hatlabs/HALSPA-hardware/HALSPA.kicad_sch

## KiCad design HALSPA.kicad_sch (2026-04-21)

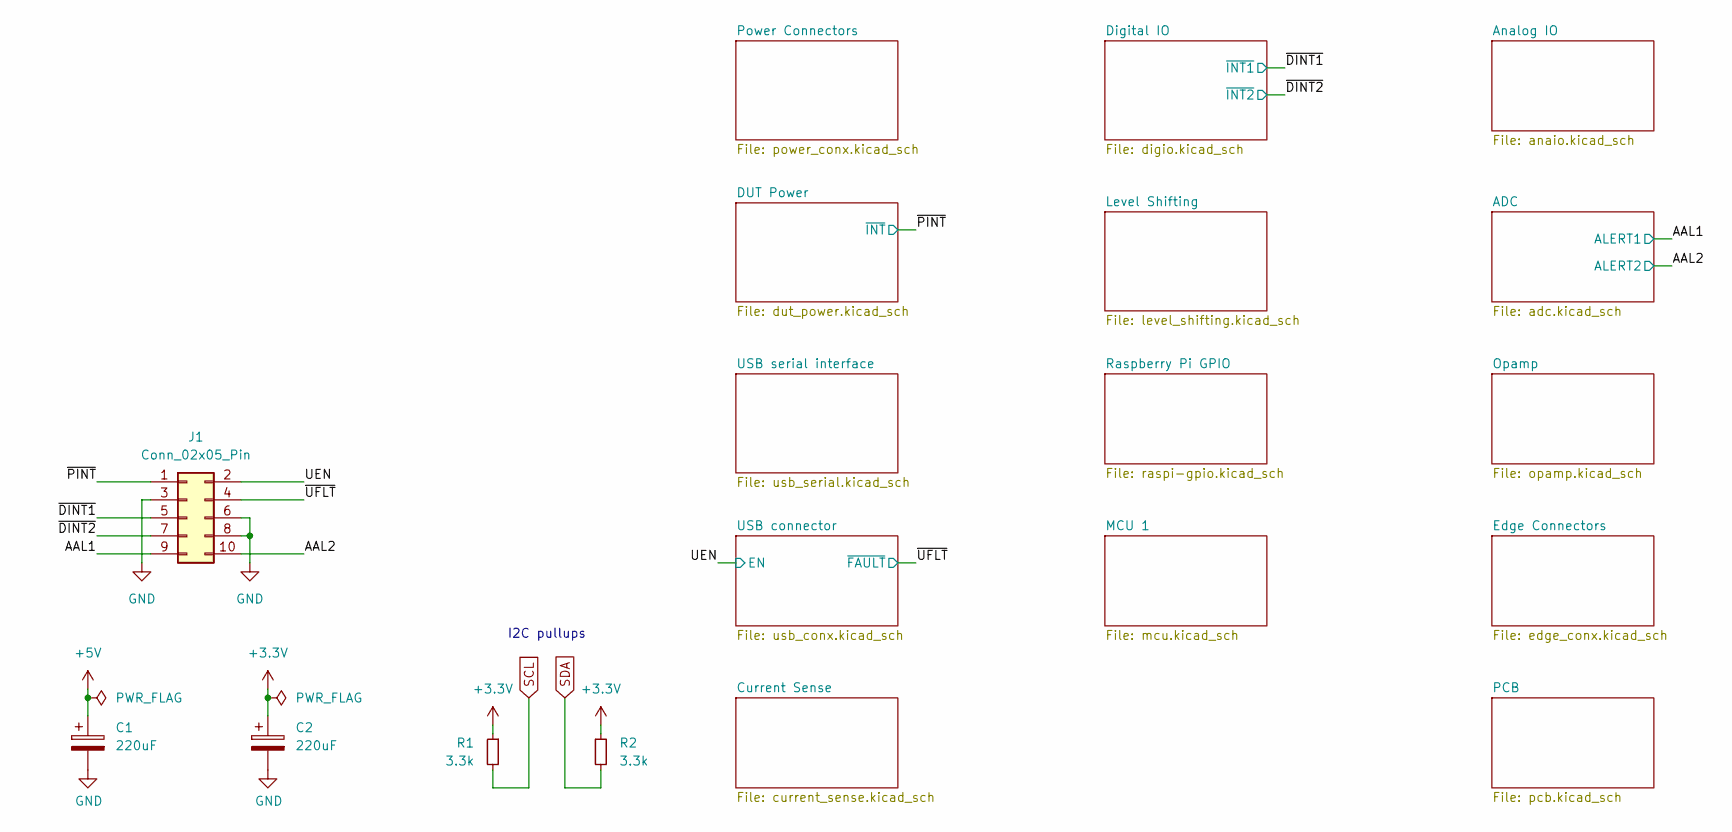
[picture p1: schematic HALSPA.kicad_sch]

Parts:
C1, C2: 220uF; CP_Elec_6.3x7.7; LCSC C5246526
J1: Conn_02x05_Pin; Pad_2x05_P2.54_1.7x1.7_2Rect-8Oct; JLCPCB_CORRECTION 1.27;-5.08;270
R1, R2: 3.3k; R_0603_1608Metric; LCSC C22978

Connections:
+3.3V: C2.1, R1.1, R2.1
+5V: C1.1
AAL1: J1.9
AAL2: J1.10
GND: C1.2, C2.2, J1.3, J1.6, J1.8
SCL: R1.2
SDA: R2.2
UEN: J1.2
~DINT1: J1.5
~DINT2: J1.7
~PINT: J1.1
~UFLT: J1.4

Notes on the sheet:
I2C pullups
