hatlabs/HALSPA-hardware/ads1115.kicad_sch

## KiCad design ads1115.kicad_sch (2026-04-21)

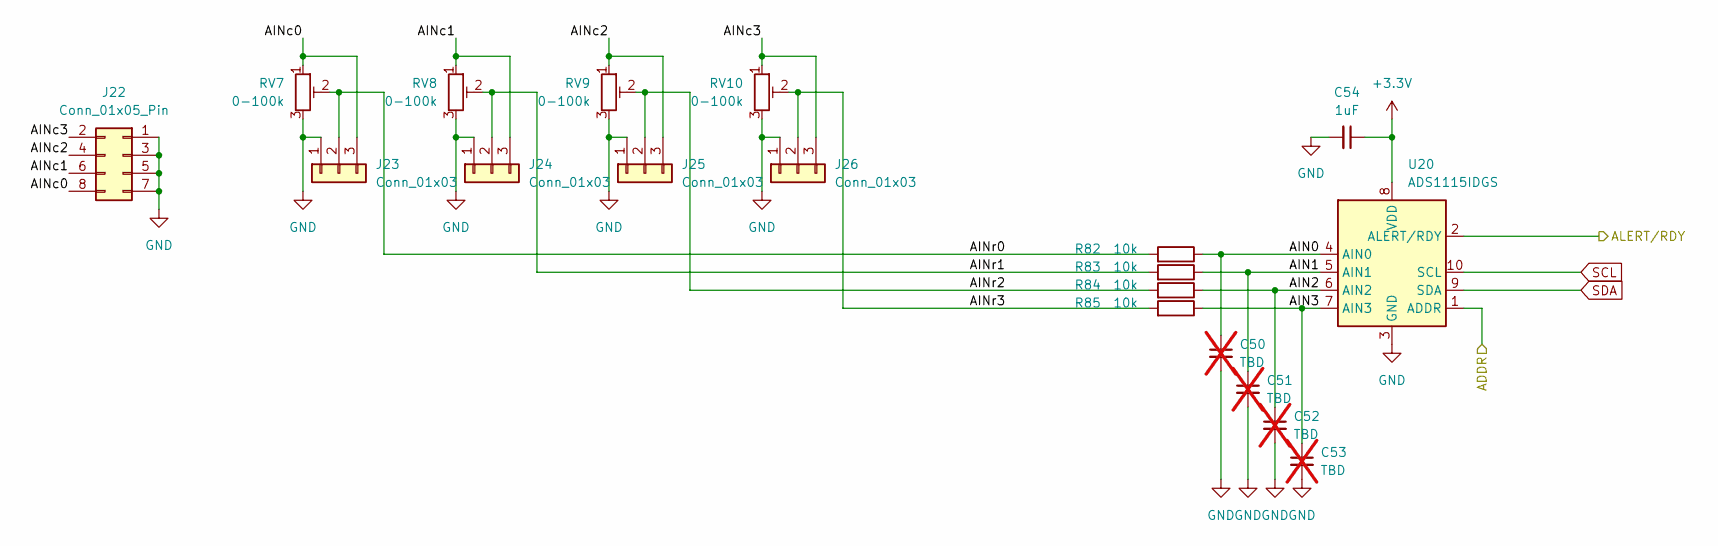
[picture p2: schematic ads1115.kicad_sch]

Parts:
C50, C51, C52, C53: TBD; C_0603_1608Metric; not fitted
C54: 1uF; C_0603_1608Metric_Pad1.08x0.95mm_HandSolder; LCSC C15849
J22: Conn_01x05_Pin; Pad_2x04_P2.54_1.7x1.7_Rect-Oct; LCSC C492421
J23, J24, J25, J26: Conn_01x03; Pad_1x03_P2.00_1.35x1.35_Rect-2Oct
R82, R83, R84, R85: 10k; R_0805_2012Metric_Pad1.20x1.40mm_HandSolder; LCSC C17414
RV7, RV8, RV9, RV10: 0-100k; RES-ADJ-TH_3P-L9.5-W4.9-P2.50-L_3296W; LCSC C118963
U20: ADS1115IDGS; TSSOP-10_3x3mm_P0.5mm; LCSC C37593

Connections:
+3.3V: C54.1, U20.8 (VDD)
ADDR: U20.1 (ADDR)
AIN0: C50.1, R82.1, U20.4 (AIN0)
AIN1: C51.1, R83.1, U20.5 (AIN1)
AIN2: C52.1, R84.1, U20.6 (AIN2)
AIN3: C53.1, R85.1, U20.7 (AIN3)
AINc0: J22.8, J23.3, RV7.1
AINc1: J22.6, J24.3, RV8.1
AINc2: J22.4, J25.3, RV9.1
AINc3: J22.2, J26.3, RV10.1
AINr0: J23.2, R82.2, RV7.2
AINr1: J24.2, R83.2, RV8.2
AINr2: J25.2, R84.2, RV9.2
AINr3: J26.2, R85.2, RV10.2
ALERT/RDY: U20.2 (ALERT/RDY)
GND: C50.2, C51.2, C52.2, C53.2, C54.2, J22.1, J22.3, J22.5, J22.7, J23.1, J24.1, J25.1, J26.1, RV7.3, RV8.3, RV9.3, RV10.3, U20.3 (GND)
SCL: U20.10 (SCL)
SDA: U20.9 (SDA)
