hatlabs/HALSPA-hardware/anaio.kicad_sch

## KiCad design anaio.kicad_sch (2026-04-21)

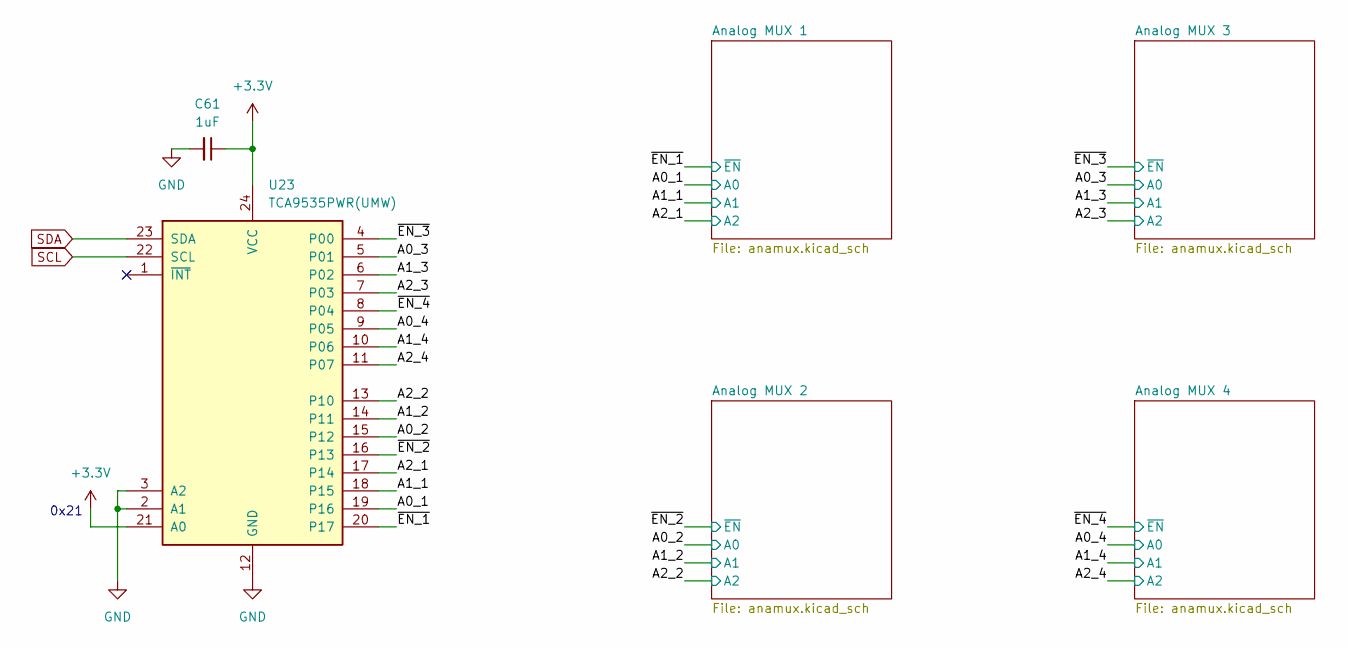
[picture p3: schematic anaio.kicad_sch]

Parts:
C61: 1uF; C_0603_1608Metric_Pad1.08x0.95mm_HandSolder; LCSC C15849
U23: TCA9535PWR(UMW); TSSOP-24_4.4x7.8mm_P0.65mm; LCSC C130204

Connections:
+3.3V: C61.1, U23.21 (A0), U23.24 (VCC)
A0_1: U23.19 (P16)
A0_2: U23.15 (P12)
A0_3: U23.5 (P01)
A0_4: U23.9 (P05)
A1_1: U23.18 (P15)
A1_2: U23.14 (P11)
A1_3: U23.6 (P02)
A1_4: U23.10 (P06)
A2_1: U23.17 (P14)
A2_2: U23.13 (P10)
A2_3: U23.7 (P03)
A2_4: U23.11 (P07)
GND: C61.2, U23.2 (A1), U23.3 (A2), U23.12 (GND)
SCL: U23.22 (SCL)
SDA: U23.23 (SDA)
~EN_1: U23.20 (P17)
~EN_2: U23.16 (P13)
~EN_3: U23.4 (P00)
~EN_4: U23.8 (P04)

Notes on the sheet:
0x21
