hatlabs/HALSPA-hardware/anamux.kicad_sch

## KiCad design anamux.kicad_sch (2026-04-21)

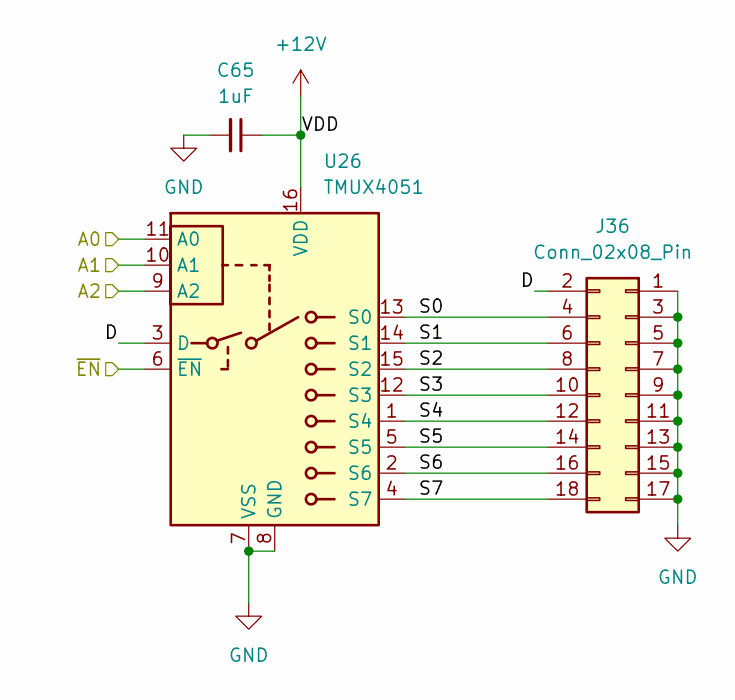
[picture p4: schematic anamux.kicad_sch]

Parts:
C65: 1uF; C_0603_1608Metric_Pad1.08x0.95mm_HandSolder; LCSC C15849
J36: Conn_02x08_Pin; Pad_2x09_P2.54_1.7x1.7_Rect-Oct; LCSC C492426
U26: TMUX4051; TSSOP-16_4.4x5mm_P0.65mm; LCSC C5449352

Connections:
+12V: C65.1, U26.16 (VDD)
A0: U26.11 (A0)
A1: U26.10 (A1)
A2: U26.9 (A2)
D: J36.2, U26.3 (D)
GND: C65.2, J36.1, J36.3, J36.5, J36.7, J36.9, J36.11, J36.13, J36.15, J36.17, U26.7 (VSS), U26.8 (GND)
S0: J36.4, U26.13 (S0)
S1: J36.6, U26.14 (S1)
S2: J36.8, U26.15 (S2)
S3: J36.10, U26.12 (S3)
S4: J36.12, U26.1 (S4)
S5: J36.14, U26.5 (S5)
S6: J36.16, U26.2 (S6)
S7: J36.18, U26.4 (S7)
~EN: U26.6 (~EN)
