hatlabs/HALSPA-hardware/buck_3.3V.kicad_sch

## KiCad design buck_3.3V.kicad_sch (2026-04-21)

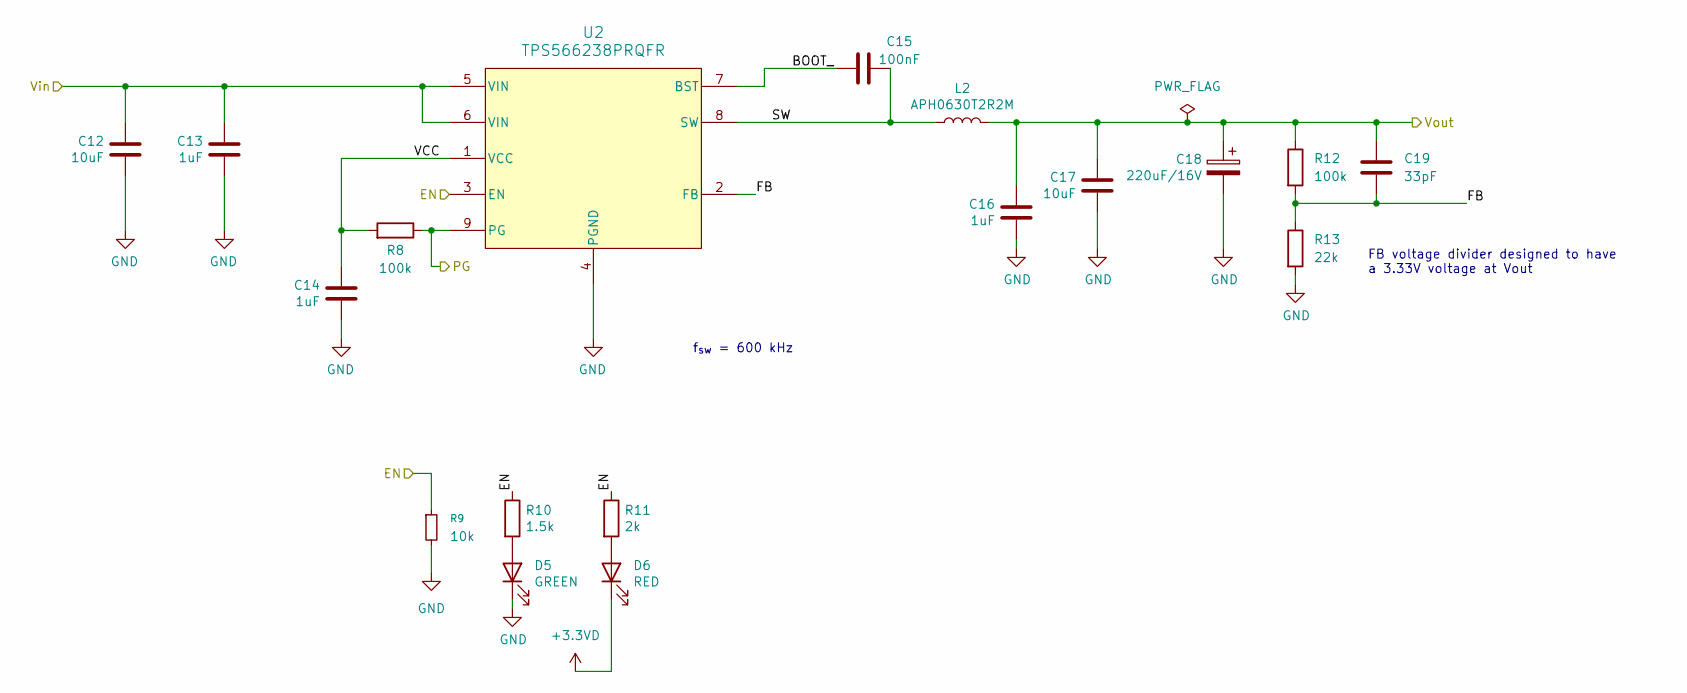
[picture p5: schematic buck_3.3V.kicad_sch]

Parts:
C12: 10uF; C_1206_3216Metric_Pad1.33x1.80mm_HandSolder; LCSC C13585
C13, C14: 1uF; C_0402_1005Metric; LCSC C52923
C15: 100nF; C_0603_1608Metric_Pad1.08x0.95mm_HandSolder; LCSC C14663
C16: 1uF; C_0603_1608Metric_Pad1.08x0.95mm_HandSolder; LCSC C15849
C17: 10uF; C_0805_2012Metric; LCSC C15850
C18: 220uF/16V; CP_Elec_6.3x7.7; LCSC C5246526
C19: 33pF; C_0402_1005Metric; LCSC C1562
D5: GREEN; LED_0603_1608Metric; LCSC C84267
D6: RED; LED_0603_1608Metric; LCSC C2286
L2: APH0630T2R2M; L_Chilisin_BMRx00060630; LCSC C5349701
R8: 100k; R_0402_1005Metric; LCSC C25741
R9: 10k; R_0603_1608Metric_Pad0.98x0.95mm_HandSolder; LCSC C25804
R10: 1.5k; R_0603_1608Metric; LCSC C22843
R11: 2k; R_0603_1608Metric; LCSC C22975
R12: 100k; R_0603_1608Metric; LCSC C25803
R13: 22k; R_0603_1608Metric; LCSC C31850
U2: TPS566238PRQFR; RQF0009A; LCSC C2876603

Connections:
+3.3VD: D6.1 (K)
BOOT_: C15.2, U2.7 (BST)
EN: R9.1, R10.1, R11.1, U2.3 (EN)
FB: C19.2, R12.2, R13.1, U2.2 (FB)
GND: C12.2, C13.2, C14.2, C16.2, C17.2, C18.2, D5.1 (K), R9.2, R13.2, U2.4 (PGND)
unnamed: D5.2 (A), R10.2
unnamed: D6.2 (A), R11.2
PG: R8.1, U2.9 (PG)
SW: C15.1, L2.1, U2.8 (SW)
VCC: C14.1, R8.2, U2.1 (VCC)
Vin: C12.1, C13.1, U2.5 (VIN), U2.6 (VIN)
Vout: C16.1, C17.1, C18.1, C19.1, L2.2, R12.1

Notes on the sheet:
FB voltage divider designed to have a 3.33V voltage at Vout
f_{sw} = 600 kHz
