hatlabs/HALSPA-hardware/buck_5V.kicad_sch

## KiCad design buck_5V.kicad_sch (2026-04-21)

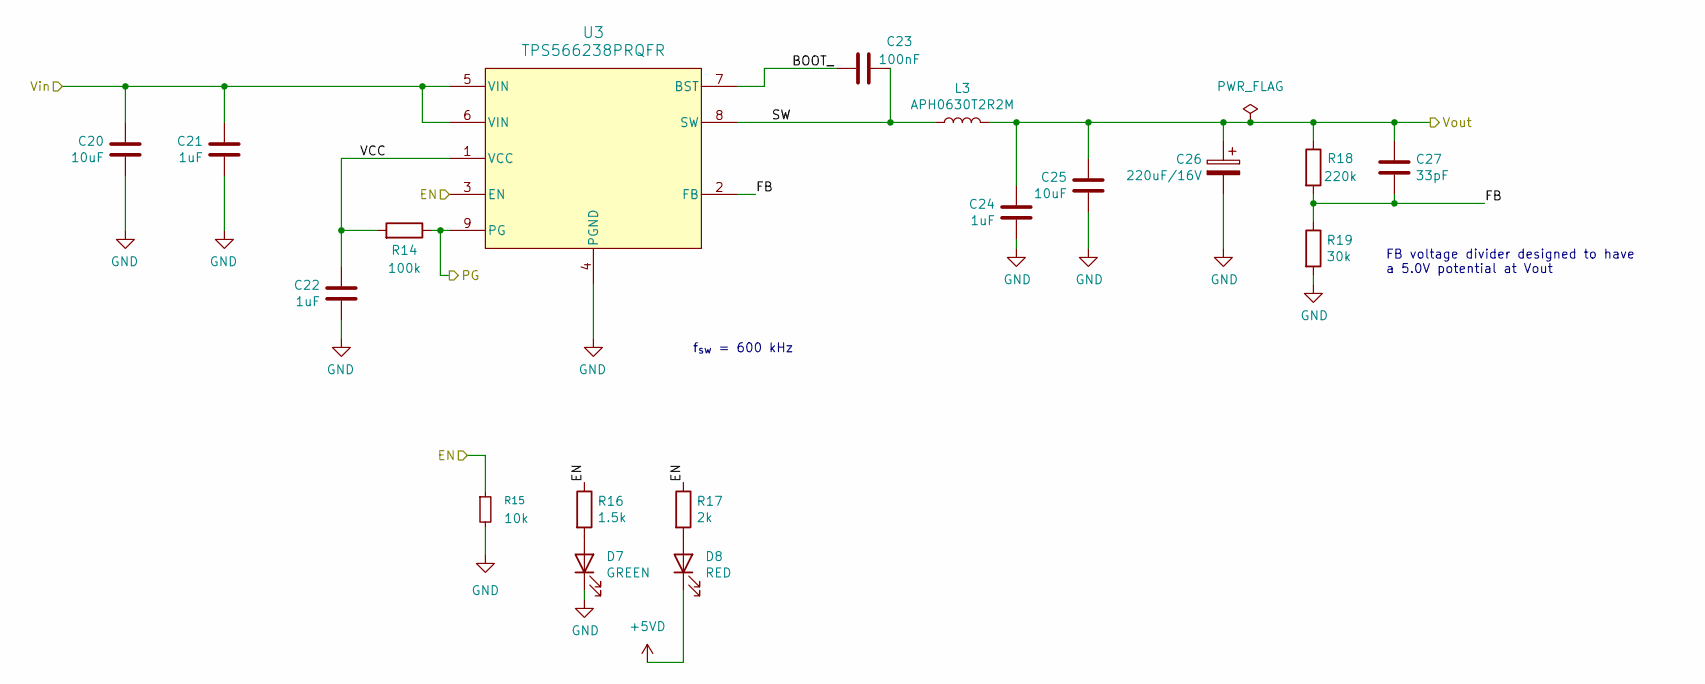
[picture p6: schematic buck_5V.kicad_sch]

Parts:
C20: 10uF; C_1206_3216Metric_Pad1.33x1.80mm_HandSolder; LCSC C13585
C21, C22: 1uF; C_0402_1005Metric; LCSC C52923
C23: 100nF; C_0603_1608Metric_Pad1.08x0.95mm_HandSolder; LCSC C14663
C24: 1uF; C_0603_1608Metric_Pad1.08x0.95mm_HandSolder; LCSC C15849
C25: 10uF; C_0805_2012Metric; LCSC C15850
C26: 220uF/16V; CP_Elec_6.3x7.7; LCSC C5246526
C27: 33pF; C_0402_1005Metric; LCSC C1562
D7: GREEN; LED_0603_1608Metric; LCSC C84267
D8: RED; LED_0603_1608Metric; LCSC C2286
L3: APH0630T2R2M; L_Chilisin_BMRx00060630; LCSC C5349701
R14: 100k; R_0402_1005Metric; LCSC C25741
R15: 10k; R_0603_1608Metric_Pad0.98x0.95mm_HandSolder; LCSC C25804
R16: 1.5k; R_0603_1608Metric; LCSC C22843
R17: 2k; R_0603_1608Metric; LCSC C22975
R18: 220k; R_0603_1608Metric; LCSC C22961
R19: 30k; R_0603_1608Metric; LCSC C22984
U3: TPS566238PRQFR; RQF0009A; LCSC C2876603

Connections:
+5VD: D8.1 (K)
BOOT_: C23.2, U3.7 (BST)
EN: R15.1, R16.1, R17.1, U3.3 (EN)
FB: C27.2, R18.2, R19.1, U3.2 (FB)
GND: C20.2, C21.2, C22.2, C24.2, C25.2, C26.2, D7.1 (K), R15.2, R19.2, U3.4 (PGND)
unnamed: D7.2 (A), R16.2
unnamed: D8.2 (A), R17.2
PG: R14.1, U3.9 (PG)
SW: C23.1, L3.1, U3.8 (SW)
VCC: C22.1, R14.2, U3.1 (VCC)
Vin: C20.1, C21.1, U3.5 (VIN), U3.6 (VIN)
Vout: C24.1, C25.1, C26.1, C27.1, L3.2, R18.1

Notes on the sheet:
FB voltage divider designed to have a 5.0V potential at Vout
f_{sw} = 600 kHz
