hatlabs/HALSPA-hardware/digio.kicad_sch

## KiCad design digio.kicad_sch (2026-04-21)

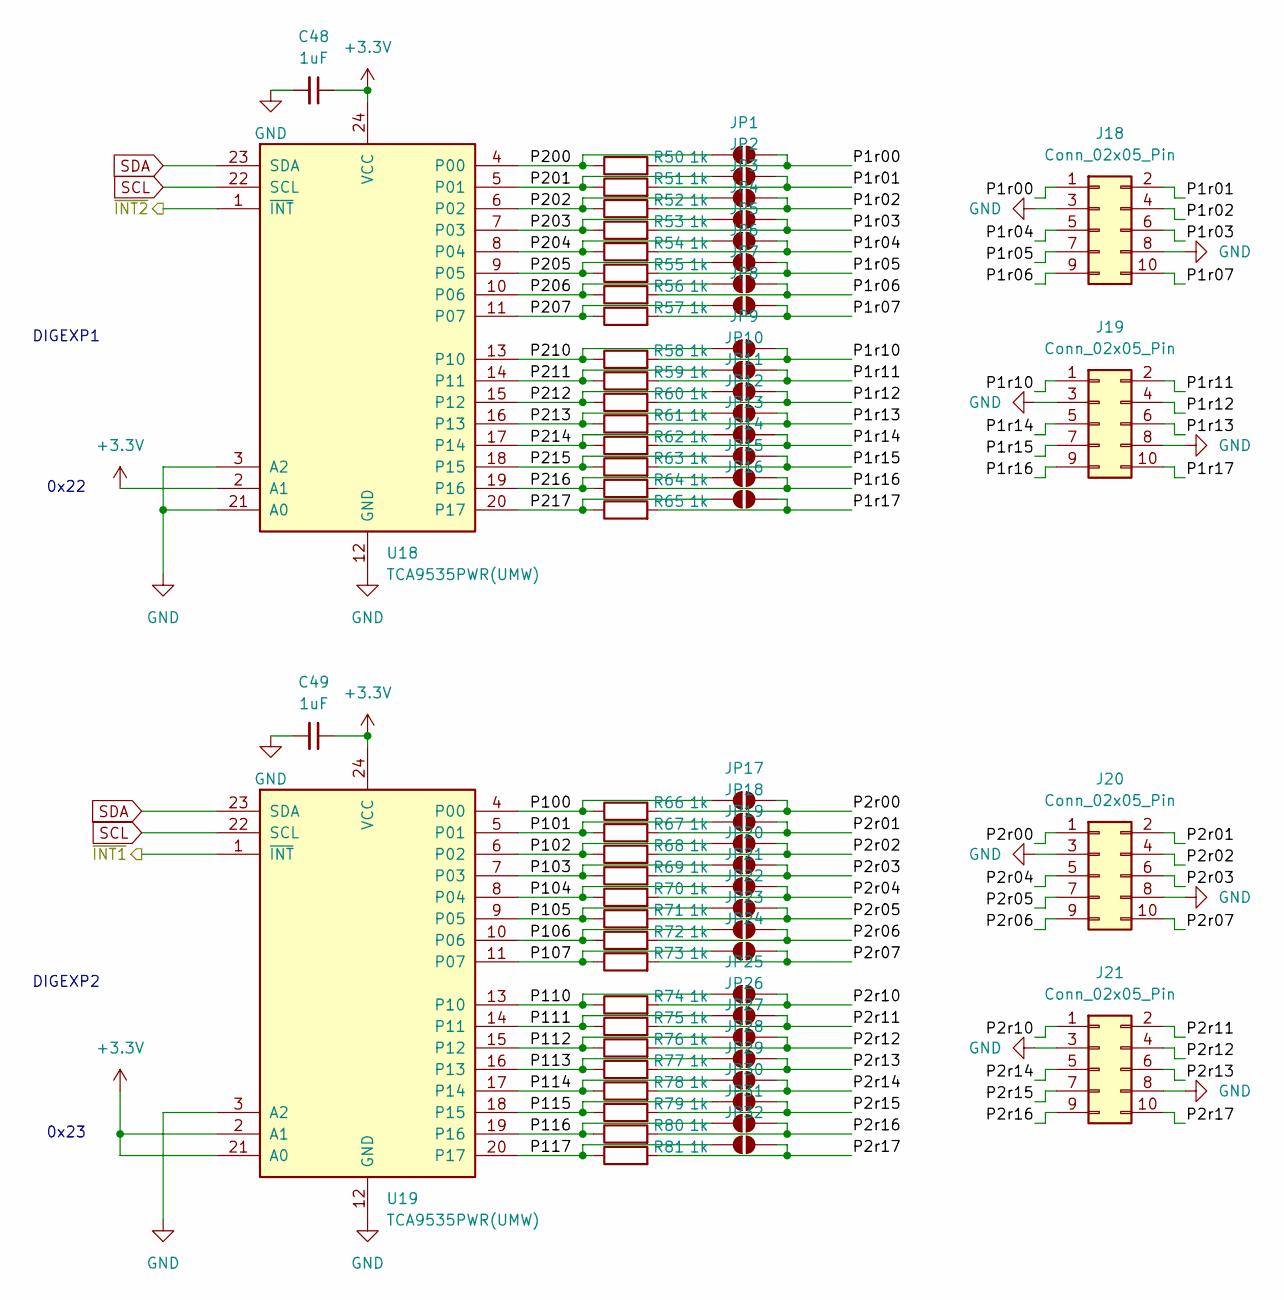
[picture p7: schematic digio.kicad_sch]

Parts:
C48, C49: 1uF; C_0603_1608Metric_Pad1.08x0.95mm_HandSolder; LCSC C15849
J18, J19, J20, J21: Conn_02x05_Pin; Pad_2x05_P2.54_1.7x1.7_2Rect-8Oct; LCSC C492422
JP1, JP2, JP3, JP4, JP5, JP6, JP7, JP8, JP9, JP10, JP11, JP12, JP13, JP14, JP15, JP16, JP17, JP18, JP19, JP20, JP21, JP22, JP23, JP24, JP25, JP26, JP27, JP28, JP29, JP30, JP31, JP32: SolderJumper_2_Open; SolderJumper-2_P1.3mm_Open_TrianglePad1.0x1.5mm
R50, R51, R52, R53, R54, R55, R56, R57, R58, R59, R60, R61, R62, R63, R64, R65, R66, R67, R68, R69, R70, R71, R72, R73, R74, R75, R76, R77, R78, R79, R80, R81: 1k; R_0603_1608Metric_Pad0.98x0.95mm_HandSolder; LCSC C21190
U18, U19: TCA9535PWR(UMW); TSSOP-24_4.4x7.8mm_P0.65mm; LCSC C130204

Connections:
+3.3V: C48.1, C49.1, U18.2 (A1), U18.24 (VCC), U19.2 (A1), U19.21 (A0), U19.24 (VCC)
GND: C48.2, C49.2, J18.3, J18.8, J19.3, J19.8, J20.3, J20.8, J21.3, J21.8, U18.3 (A2), U18.12 (GND), U18.21 (A0), U19.3 (A2), U19.12 (GND)
P1r00: J18.1, JP1.2 (B), R50.2
P1r01: J18.2, JP2.2 (B), R51.2
P1r02: J18.4, JP3.2 (B), R52.2
P1r03: J18.6, JP4.2 (B), R53.2
P1r04: J18.5, JP5.2 (B), R54.2
P1r05: J18.7, JP6.2 (B), R55.2
P1r06: J18.9, JP7.2 (B), R56.2
P1r07: J18.10, JP8.2 (B), R57.2
P1r10: J19.1, JP9.2 (B), R58.2
P1r11: J19.2, JP10.2 (B), R59.2
P1r12: J19.4, JP11.2 (B), R60.2
P1r13: J19.6, JP12.2 (B), R61.2
P1r14: J19.5, JP13.2 (B), R62.2
P1r15: J19.7, JP14.2 (B), R63.2
P1r16: J19.9, JP15.2 (B), R64.2
P1r17: J19.10, JP16.2 (B), R65.2
P2r00: J20.1, JP17.2 (B), R66.2
P2r01: J20.2, JP18.2 (B), R67.2
P2r02: J20.4, JP19.2 (B), R68.2
P2r03: J20.6, JP20.2 (B), R69.2
P2r04: J20.5, JP21.2 (B), R70.2
P2r05: J20.7, JP22.2 (B), R71.2
P2r06: J20.9, JP23.2 (B), R72.2
P2r07: J20.10, JP24.2 (B), R73.2
P2r10: J21.1, JP25.2 (B), R74.2
P2r11: J21.2, JP26.2 (B), R75.2
P2r12: J21.4, JP27.2 (B), R76.2
P2r13: J21.6, JP28.2 (B), R77.2
P2r14: J21.5, JP29.2 (B), R78.2
P2r15: J21.7, JP30.2 (B), R79.2
P2r16: J21.9, JP31.2 (B), R80.2
P2r17: J21.10, JP32.2 (B), R81.2
P100: JP17.1 (A), R66.1, U19.4 (P00)
P101: JP18.1 (A), R67.1, U19.5 (P01)
P102: JP19.1 (A), R68.1, U19.6 (P02)
P103: JP20.1 (A), R69.1, U19.7 (P03)
P104: JP21.1 (A), R70.1, U19.8 (P04)
P105: JP22.1 (A), R71.1, U19.9 (P05)
P106: JP23.1 (A), R72.1, U19.10 (P06)
P107: JP24.1 (A), R73.1, U19.11 (P07)
P110: JP25.1 (A), R74.1, U19.13 (P10)
P111: JP26.1 (A), R75.1, U19.14 (P11)
P112: JP27.1 (A), R76.1, U19.15 (P12)
P113: JP28.1 (A), R77.1, U19.16 (P13)
P114: JP29.1 (A), R78.1, U19.17 (P14)
P115: JP30.1 (A), R79.1, U19.18 (P15)
P116: JP31.1 (A), R80.1, U19.19 (P16)
P117: JP32.1 (A), R81.1, U19.20 (P17)
P200: JP1.1 (A), R50.1, U18.4 (P00)
P201: JP2.1 (A), R51.1, U18.5 (P01)
P202: JP3.1 (A), R52.1, U18.6 (P02)
P203: JP4.1 (A), R53.1, U18.7 (P03)
P204: JP5.1 (A), R54.1, U18.8 (P04)
P205: JP6.1 (A), R55.1, U18.9 (P05)
P206: JP7.1 (A), R56.1, U18.10 (P06)
P207: JP8.1 (A), R57.1, U18.11 (P07)
P210: JP9.1 (A), R58.1, U18.13 (P10)
P211: JP10.1 (A), R59.1, U18.14 (P11)
P212: JP11.1 (A), R60.1, U18.15 (P12)
P213: JP12.1 (A), R61.1, U18.16 (P13)
P214: JP13.1 (A), R62.1, U18.17 (P14)
P215: JP14.1 (A), R63.1, U18.18 (P15)
P216: JP15.1 (A), R64.1, U18.19 (P16)
P217: JP16.1 (A), R65.1, U18.20 (P17)
SCL: U18.22 (SCL), U19.22 (SCL)
SDA: U18.23 (SDA), U19.23 (SDA)
~INT1: U19.1 (~INT)
~INT2: U18.1 (~INT)

Notes on the sheet:
0x22
DIGEXP2
DIGEXP1
0x23
