hatlabs/HALSPA-hardware/dut_power.kicad_sch

## KiCad design dut_power.kicad_sch (2026-04-21)

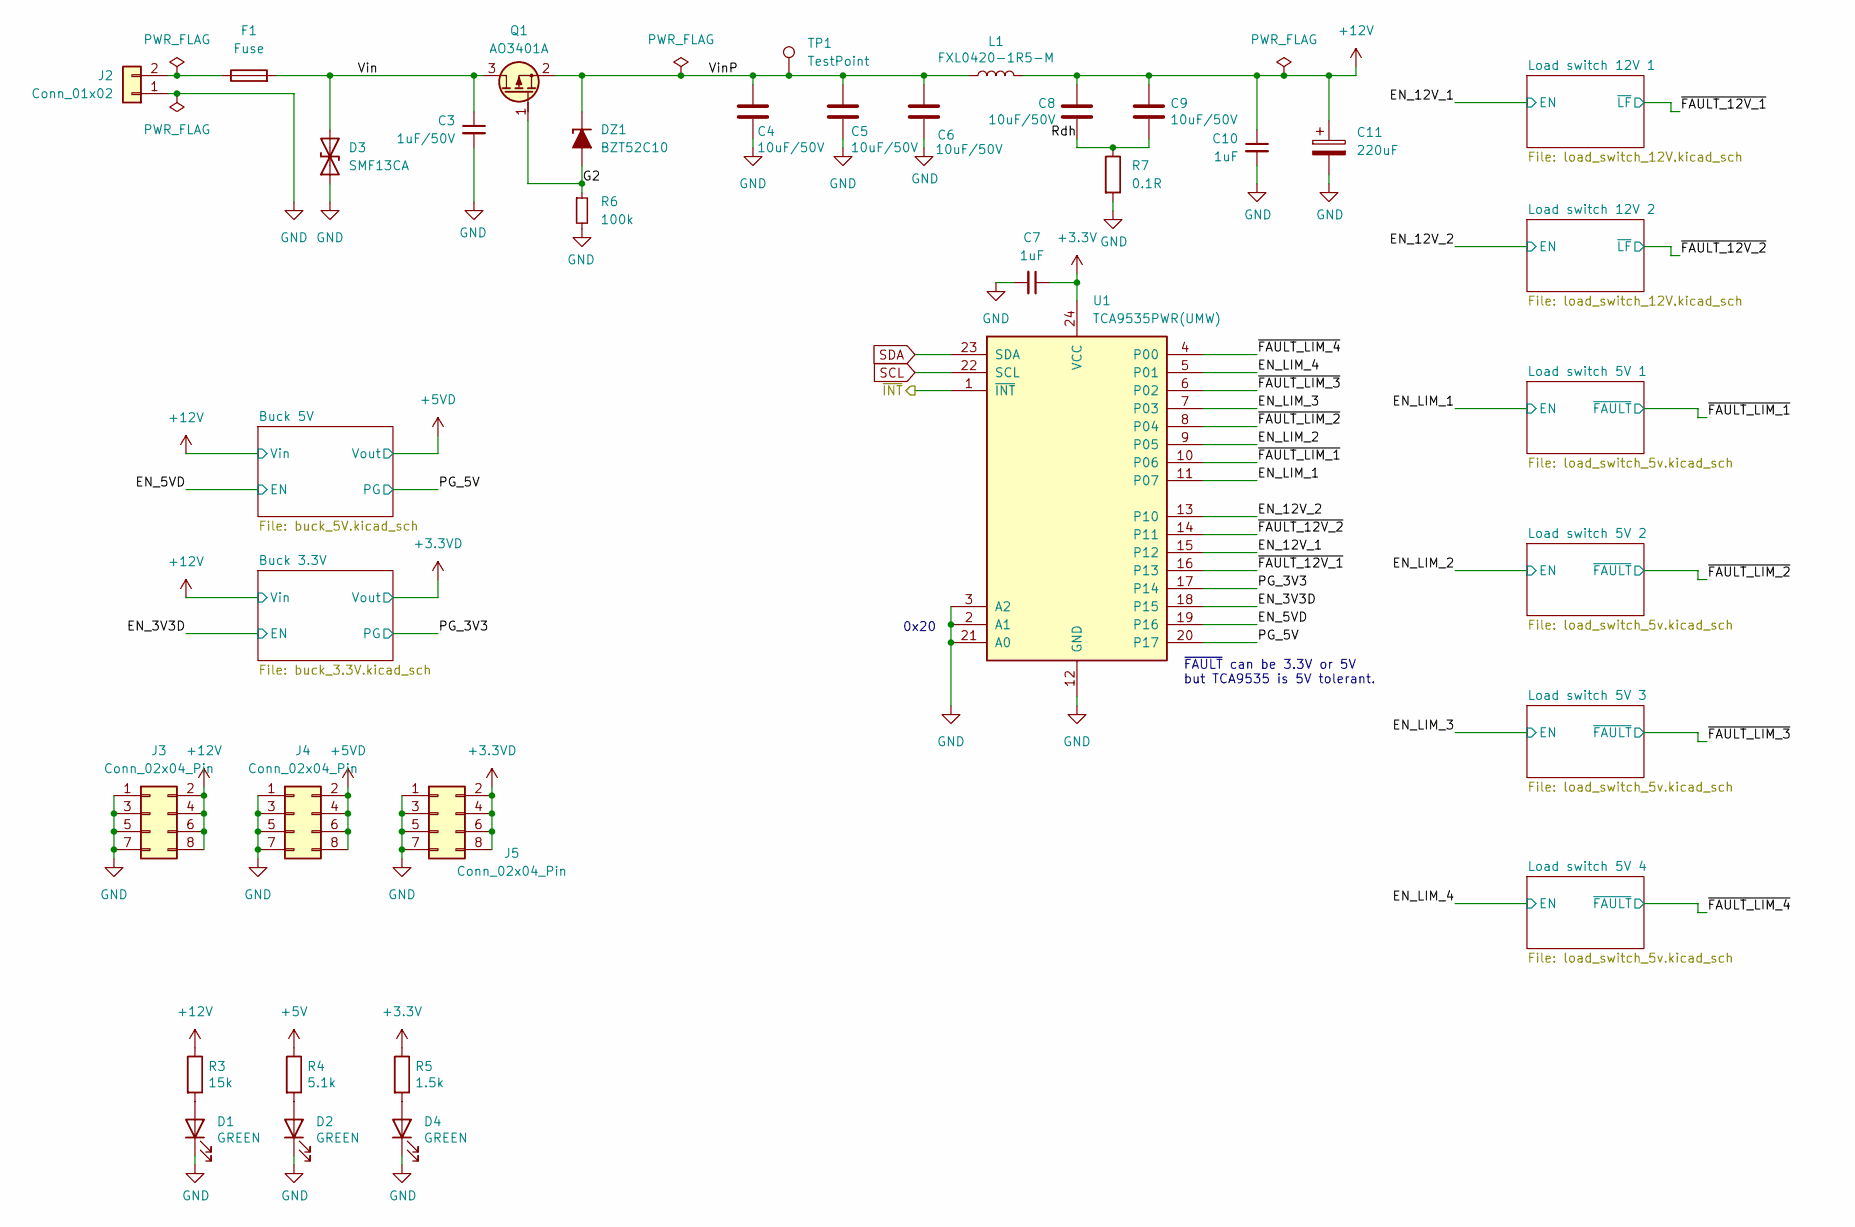
[picture p8: schematic dut_power.kicad_sch]

Parts:
C3: 1uF/50V; C_1206_3216Metric; LCSC C1848
C4, C5, C6, C8, C9: 10uF/50V; C_1206_3216Metric; LCSC C13585
C7, C10: 1uF; C_0603_1608Metric_Pad1.08x0.95mm_HandSolder; LCSC C15849
C11: 220uF; CP_Elec_6.3x7.7; LCSC C5246526
D1, D2, D4: GREEN; LED_0603_1608Metric; LCSC C84267
D3: SMF13CA; D_SOD-123; LCSC C699053
DZ1: BZT52C10; D_SOD-123; LCSC C173431
F1: Fuse; FUSE-TH_L22.6-W9.0; LCSC C3131
J2: Conn_01x02; PhoenixContact_MCV_1,5_2-G-3.81_1x02_P3.81mm_Vertical; LCSC C8396
J3, J4, J5: Conn_02x04_Pin; Pad_2x04_P2.54_1.7x1.7_Rect-Rnd; LCSC C7501275
L1: FXL0420-1R5-M; L_MWSA0402; LCSC C167205
Q1: AO3401A; SOT-23_Handsoldering; LCSC C15127
R3: 15k; R_0603_1608Metric; LCSC C22809
R4: 5.1k; R_0603_1608Metric; LCSC C23186
R5: 1.5k; R_0603_1608Metric; LCSC C22843
R6: 100k; R_0603_1608Metric; LCSC C25803
R7: 0.1R; R_1206_3216Metric; LCSC C25334
TP1: TestPoint; TestPoint_Pad_D1.0mm
U1: TCA9535PWR(UMW); TSSOP-24_4.4x7.8mm_P0.65mm; LCSC C130204

Connections:
+3.3V: C7.1, R5.1, U1.24 (VCC)
+3.3VD: J5.2, J5.4, J5.6, J5.8
+5V: R4.1
+5VD: J4.2, J4.4, J4.6, J4.8
+12V: C8.1, C9.1, C10.1, C11.1, J3.2, J3.4, J3.6, J3.8, L1.2, R3.1
EN_3V3D: U1.18 (P15)
EN_5VD: U1.19 (P16)
EN_12V_1: U1.15 (P12)
EN_12V_2: U1.13 (P10)
EN_LIM_1: U1.11 (P07)
EN_LIM_2: U1.9 (P05)
EN_LIM_3: U1.7 (P03)
EN_LIM_4: U1.5 (P01)
G2: DZ1.2 (A), Q1.1 (G), R6.1
GND: C3.2, C4.2, C5.2, C6.2, C7.2, C10.2, C11.2, D1.1 (K), D2.1 (K), D3.1 (A1), D4.1 (K), J2.1, J3.1, J3.3, J3.5, J3.7, J4.1, J4.3, J4.5, J4.7, J5.1, J5.3, J5.5, J5.7, R6.2, R7.2, U1.2 (A1), U1.3 (A2), U1.12 (GND), U1.21 (A0)
unnamed: D1.2 (A), R3.2
unnamed: D2.2 (A), R4.2
unnamed: D4.2 (A), R5.2
unnamed: F1.1, J2.2
PG_3V3: U1.17 (P14)
PG_5V: U1.20 (P17)
Rdh: C8.2, C9.2, R7.1
SCL: U1.22 (SCL)
SDA: U1.23 (SDA)
Vin: C3.1, D3.2 (A2), F1.2, Q1.3 (D)
VinP: C4.1, C5.1, C6.1, DZ1.1 (K), L1.1, Q1.2 (S), TP1.1
~FAULT_12V_1: U1.16 (P13)
~FAULT_12V_2: U1.14 (P11)
~FAULT_LIM_1: U1.10 (P06)
~FAULT_LIM_2: U1.8 (P04)
~FAULT_LIM_3: U1.6 (P02)
~FAULT_LIM_4: U1.4 (P00)
~INT: U1.1 (~INT)

Notes on the sheet:
0x20
~{FAULT} can be 3.3V or 5V but TCA9535 is 5V tolerant.
