hatlabs/HALSPA-hardware/edge_conx.kicad_sch

## KiCad design edge_conx.kicad_sch (2026-04-21)

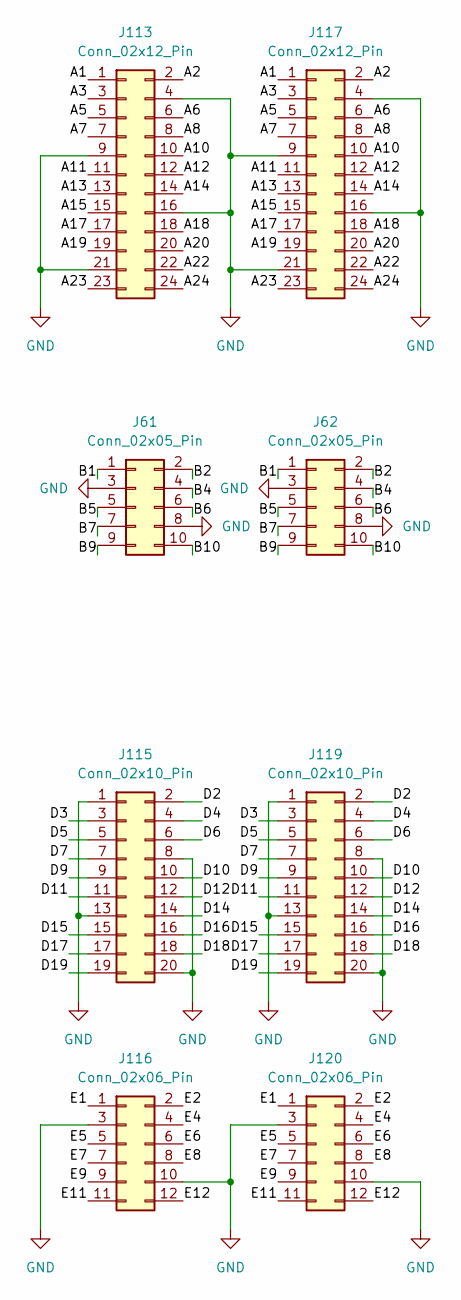
[picture p9: schematic edge_conx.kicad_sch]

Parts:
J61, J62: Conn_02x05_Pin; Pad_2x05_P2.54_1.7x1.7_2Rect-8Oct; LCSC C492422
J113, J117: Conn_02x12_Pin; Pad_2x12_P2.54_1.7x1.7_4Rect_18Oct; LCSC C7430408
J115, J119: Conn_02x10_Pin; Pad_2x10_P2.54_1.7x1.7_4Rect_16Oct; LCSC C7430406
J116, J120: Conn_02x06_Pin; Pad_2x06_P2.54_1.7x1.7_2Rect-10Oct; LCSC C7501277

Connections:
A1: J113.1, J117.1
A2: J113.2, J117.2
A3: J113.3, J117.3
A5: J113.5, J117.5
A6: J113.6, J117.6
A7: J113.7, J117.7
A8: J113.8, J117.8
A10: J113.10, J117.10
A11: J113.11, J117.11
A12: J113.12, J117.12
A13: J113.13, J117.13
A14: J113.14, J117.14
A15: J113.15, J117.15
A17: J113.17, J117.17
A18: J113.18, J117.18
A19: J113.19, J117.19
A20: J113.20, J117.20
A22: J113.22, J117.22
A23: J113.23, J117.23
A24: J113.24, J117.24
B1: J61.1, J62.1
B2: J61.2, J62.2
B4: J61.4, J62.4
B5: J61.5, J62.5
B6: J61.6, J62.6
B7: J61.7, J62.7
B9: J61.9, J62.9
B10: J61.10, J62.10
D2: J115.2, J119.2
D3: J115.3, J119.3
D4: J115.4, J119.4
D5: J115.5, J119.5
D6: J115.6, J119.6
D7: J115.7, J119.7
D9: J115.9, J119.9
D10: J115.10, J119.10
D11: J115.11, J119.11
D12: J115.12, J119.12
D14: J115.14, J119.14
D15: J115.15, J119.15
D16: J115.16, J119.16
D17: J115.17, J119.17
D18: J115.18, J119.18
D19: J115.19, J119.19
E1: J116.1, J120.1
E2: J116.2, J120.2
E4: J116.4, J120.4
E5: J116.5, J120.5
E6: J116.6, J120.6
E7: J116.7, J120.7
E8: J116.8, J120.8
E9: J116.9, J120.9
E11: J116.11, J120.11
E12: J116.12, J120.12
GND: J61.3, J61.8, J62.3, J62.8, J113.4, J113.9, J113.16, J113.21, J115.1, J115.8, J115.13, J115.20, J116.3, J116.10, J117.4, J117.9, J117.16, J117.21, J119.1, J119.8, J119.13, J119.20, J120.3, J120.10
