hatlabs/HALSPA-hardware/filters.kicad_sch

## KiCad design filters.kicad_sch (2025-04-17)

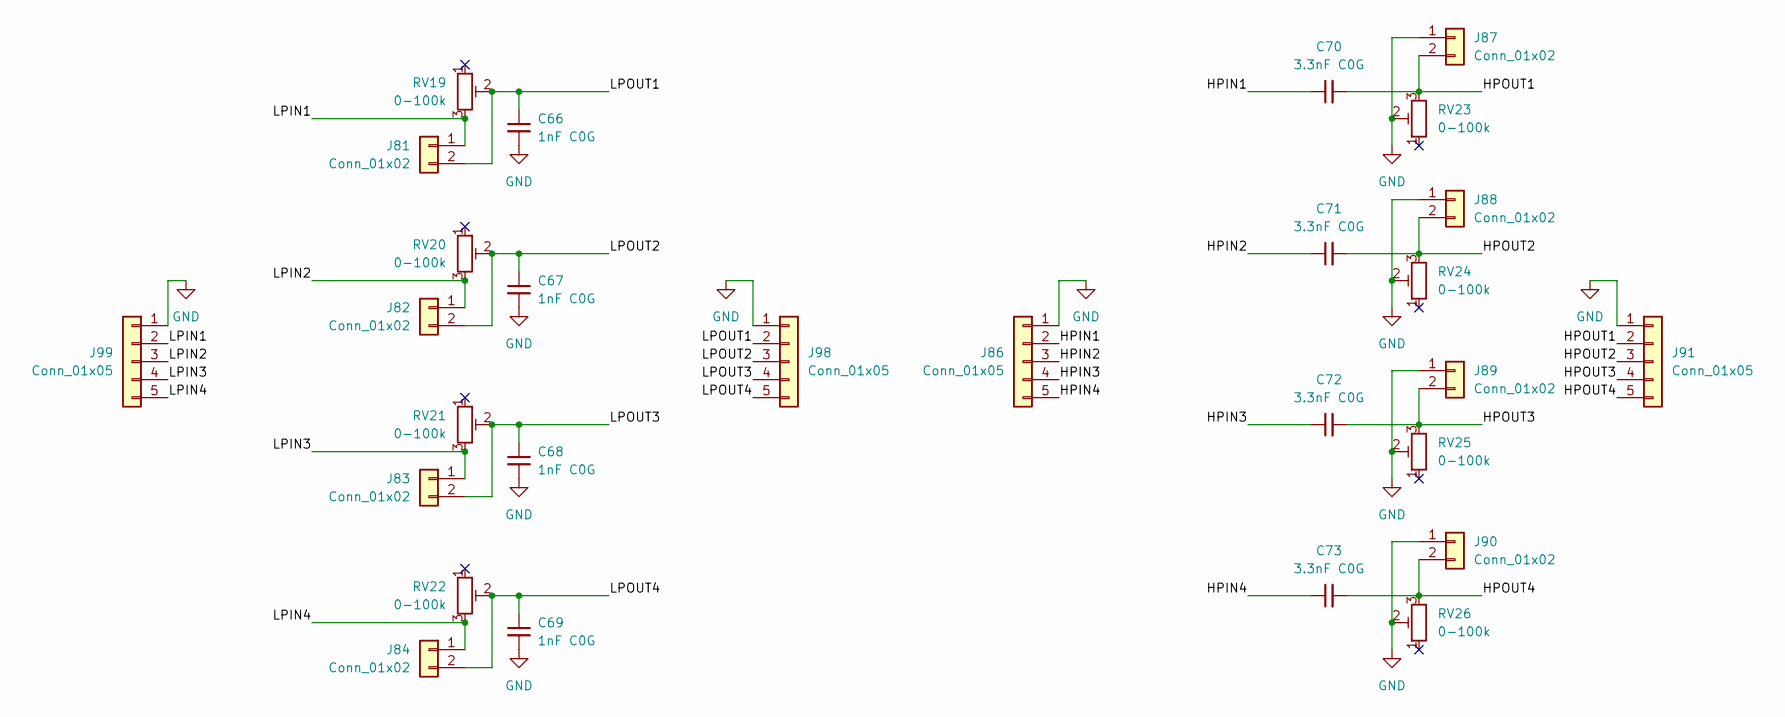
[picture p10: schematic filters.kicad_sch]

Parts:
C66, C67, C68, C69: 1nF C0G; C_0603_1608Metric; LCSC C77026
C70, C71, C72, C73: 3.3nF C0G; C_0603_1608Metric; LCSC C77036
J81, J82, J83, J84: Conn_01x02; Pad_1x02_P2.00_1.35x1.35_Oct
J86, J91, J98, J99: Conn_01x05; Pad_1x05_P2.54_1.7x1.7_Rect-Oct
J87, J88, J89, J90: Conn_01x02; Pad_1x02_P2.00_1.35x1.35_Rect-Oct
RV19, RV20, RV21, RV22, RV23, RV24, RV25, RV26: 0-100k; RES-ADJ-TH_3P-L9.5-W4.9-P2.50-L_3296W; LCSC C118963

Connections:
GND: C66.2, C67.2, C68.2, C69.2, J86.1, J87.1, J88.1, J89.1, J90.1, J91.1, J98.1, J99.1, RV23.2, RV24.2, RV25.2, RV26.2
HPIN1: C70.1, J86.2
HPIN2: C71.1, J86.3
HPIN3: C72.1, J86.4
HPIN4: C73.1, J86.5
HPOUT1: C70.2, J87.2, J91.2, RV23.3
HPOUT2: C71.2, J88.2, J91.3, RV24.3
HPOUT3: C72.2, J89.2, J91.4, RV25.3
HPOUT4: C73.2, J90.2, J91.5, RV26.3
LPIN1: J81.1, J99.2, RV19.3
LPIN2: J82.1, J99.3, RV20.3
LPIN3: J83.1, J99.4, RV21.3
LPIN4: J84.1, J99.5, RV22.3
LPOUT1: C66.1, J81.2, J98.2, RV19.2
LPOUT2: C67.1, J82.2, J98.3, RV20.2
LPOUT3: C68.1, J83.2, J98.4, RV21.2
LPOUT4: C69.1, J84.2, J98.5, RV22.2
