hatlabs/HALSPA-hardware/ina199.kicad_sch

## KiCad design ina199.kicad_sch (2026-04-21)

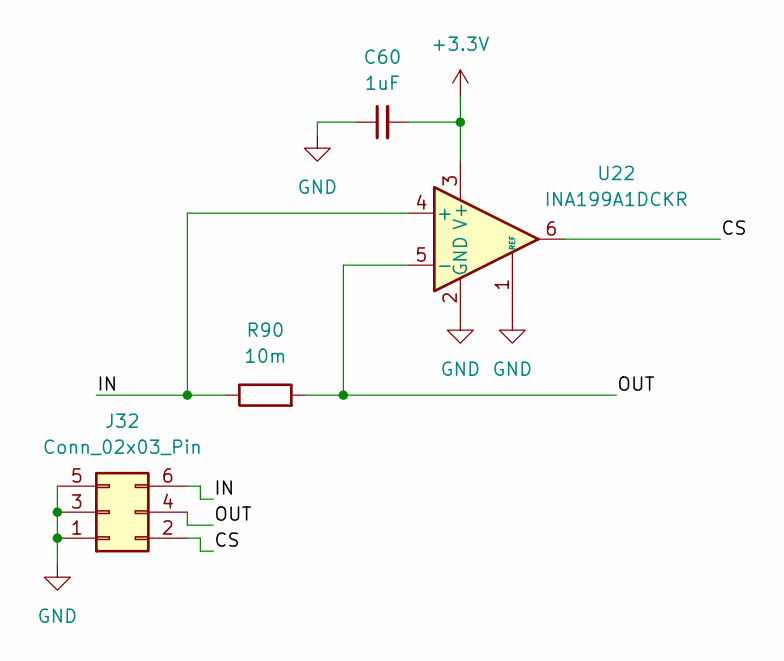
[picture p11: schematic ina199.kicad_sch]

Parts:
C60: 1uF; C_0603_1608Metric_Pad1.08x0.95mm_HandSolder; LCSC C15849
J32: Conn_02x03_Pin; Pad_2x03_P2.54_1.7x1.7_Rect-1Oct-2Rnd; LCSC C2685197
R90: 10m; R_1206_3216Metric_Pad1.30x1.75mm_HandSolder; LCSC C105362
U22: INA199A1DCKR; SOT-363_SC-70-6; LCSC C59135

Connections:
+3.3V: C60.2, U22.3 (V+)
CS: J32.2, U22.6
GND: C60.1, J32.1, J32.3, J32.5, U22.1 (REF), U22.2 (GND)
IN: J32.6, R90.1, U22.4 (+)
OUT: J32.4, R90.2, U22.5 (-)
