hatlabs/HALSPA-hardware/level_shifting.kicad_sch

## KiCad design level_shifting.kicad_sch (2026-04-21)

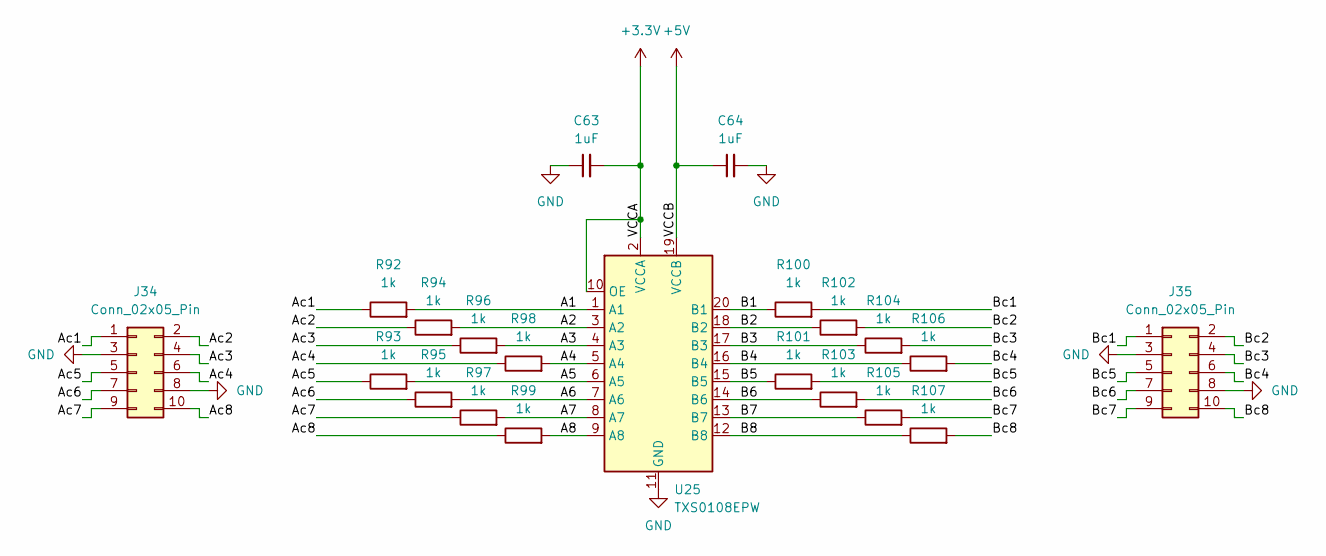
[picture p12: schematic level_shifting.kicad_sch]

Parts:
C63, C64: 1uF; C_0603_1608Metric_Pad1.08x0.95mm_HandSolder; LCSC C15849
J34, J35: Conn_02x05_Pin; Pad_2x05_P2.54_1.7x1.7_2Rect-8Oct; LCSC C492422
R92, R93, R94, R95, R96, R97, R98, R99, R100, R101, R102, R103, R104, R105, R106, R107: 1k; R_0603_1608Metric_Pad0.98x0.95mm_HandSolder; LCSC C21190
U25: TXS0108EPW; TSSOP-20_4.4x6.5mm_P0.65mm; LCSC C17206

Connections:
+3.3V: C63.2, U25.2 (VCCA), U25.10 (OE)
+5V: C64.1, U25.19 (VCCB)
A1: R92.2, U25.1 (A1)
A2: R94.2, U25.3 (A2)
A3: R96.2, U25.4 (A3)
A4: R98.2, U25.5 (A4)
A5: R93.2, U25.6 (A5)
A6: R95.2, U25.7 (A6)
A7: R97.2, U25.8 (A7)
A8: R99.2, U25.9 (A8)
Ac1: J34.1, R92.1
Ac2: J34.2, R94.1
Ac3: J34.4, R96.1
Ac4: J34.6, R98.1
Ac5: J34.5, R93.1
Ac6: J34.7, R95.1
Ac7: J34.9, R97.1
Ac8: J34.10, R99.1
B1: R100.1, U25.20 (B1)
B2: R102.1, U25.18 (B2)
B3: R104.1, U25.17 (B3)
B4: R106.1, U25.16 (B4)
B5: R101.1, U25.15 (B5)
B6: R103.1, U25.14 (B6)
B7: R105.1, U25.13 (B7)
B8: R107.1, U25.12 (B8)
Bc1: J35.1, R100.2
Bc2: J35.2, R102.2
Bc3: J35.4, R104.2
Bc4: J35.6, R106.2
Bc5: J35.5, R101.2
Bc6: J35.7, R103.2
Bc7: J35.9, R105.2
Bc8: J35.10, R107.2
GND: C63.1, C64.2, J34.3, J34.8, J35.3, J35.8, U25.11 (GND)
