hatlabs/HALSPA-hardware/load_switch_5v.kicad_sch

## KiCad design load_switch_5v.kicad_sch (2026-04-21)

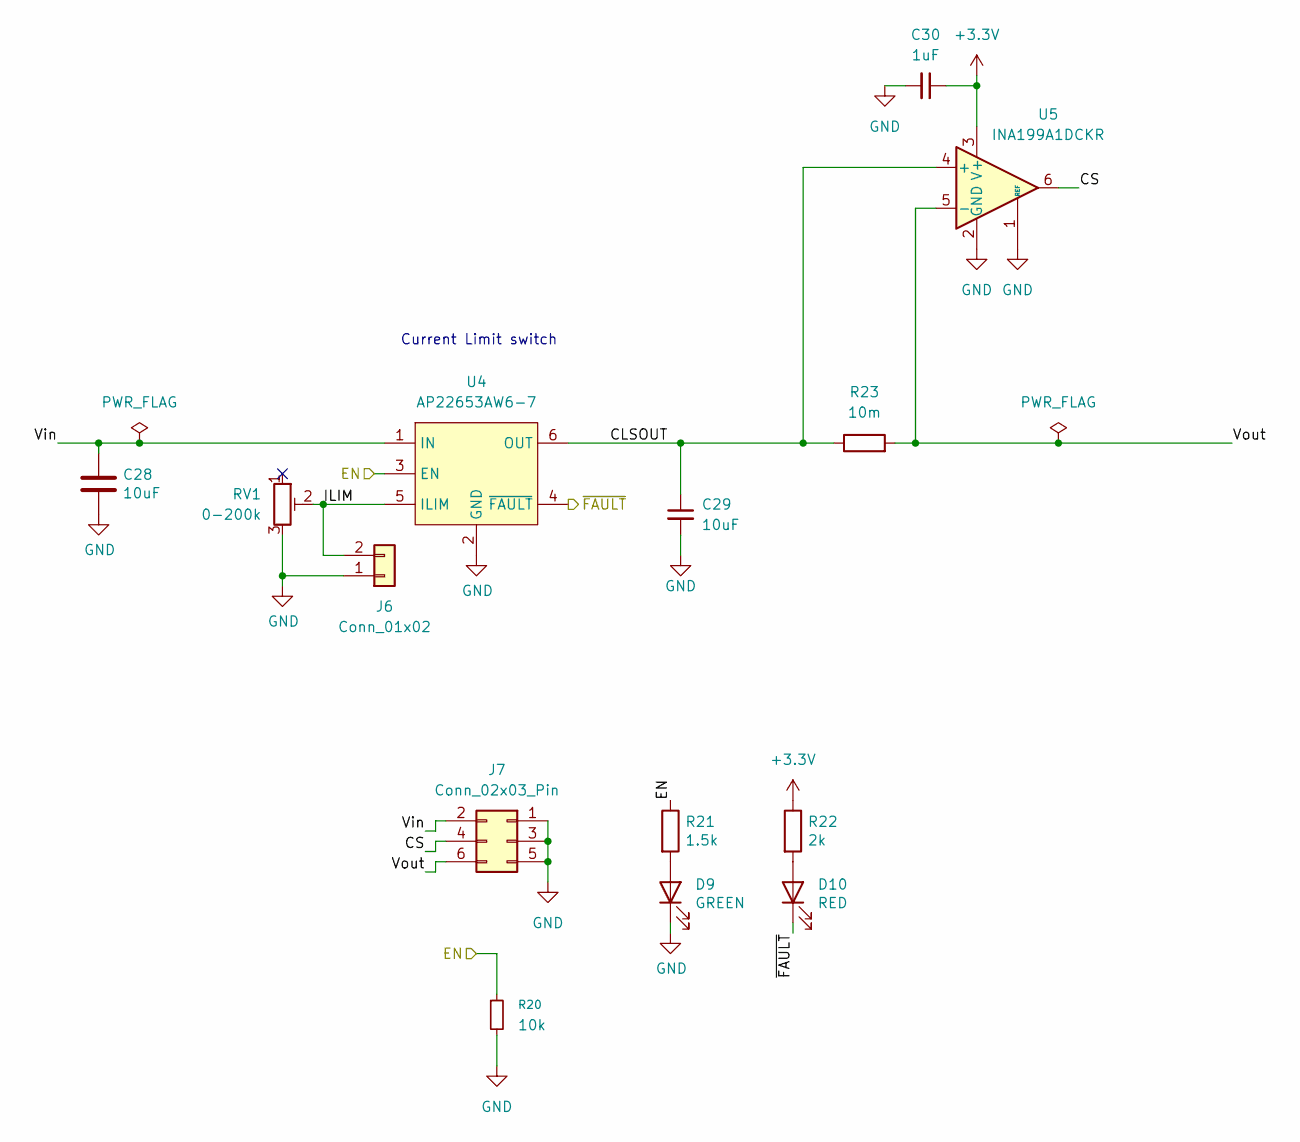
[picture p13: schematic load_switch_5v.kicad_sch]

Parts:
C28, C29: 10uF; C_0805_2012Metric; LCSC C15850
C30: 1uF; C_0603_1608Metric_Pad1.08x0.95mm_HandSolder; LCSC C15849
D9: GREEN; LED_0603_1608Metric; LCSC C84267
D10: RED; LED_0603_1608Metric; LCSC C2286
J6: Conn_01x02; Pad_1x02_P2.00_1.35x1.35_Rect-Oct
J7: Conn_02x03_Pin; Pad_2x03_P2.54_1.7x1.7_Rect-Rnd-Oct-Rnd; LCSC C2685197
R20: 10k; R_0603_1608Metric_Pad0.98x0.95mm_HandSolder; LCSC C25804
R21: 1.5k; R_0603_1608Metric; LCSC C22843
R22: 2k; R_0603_1608Metric; LCSC C22975
R23: 10m; R_1206_3216Metric_Pad1.30x1.75mm_HandSolder; LCSC C105362
RV1: 0-200k; RES-ADJ-TH_3P-L9.5-W4.9-P2.50-L_3296W; LCSC C118942
U4: AP22653AW6-7; SOT-23-6; LCSC C1511768
U5: INA199A1DCKR; SOT-363_SC-70-6; LCSC C59135

Connections:
+3.3V: C30.1, R22.1, U5.3 (V+)
CLSOUT: C29.1, R23.1, U4.6 (OUT), U5.4 (+)
CS: J7.4, U5.6
EN: R20.1, R21.1, U4.3 (EN)
GND: C28.2, C29.2, C30.2, D9.1 (K), J6.1, J7.1, J7.3, J7.5, R20.2, RV1.3, U4.2 (GND), U5.1 (REF), U5.2 (GND)
ILIM: J6.2, RV1.2, U4.5 (ILIM)
unnamed: D9.2 (A), R21.2
unnamed: D10.2 (A), R22.2
Vin: C28.1, J7.2, U4.1 (IN)
Vout: J7.6, R23.2, U5.5 (-)
~FAULT: D10.1 (K), U4.4 (~FAULT)

Notes on the sheet:
Current Limit switch
