hatlabs/HALSPA-hardware/load_switch_12V.kicad_sch

## KiCad design load_switch_12V.kicad_sch (2026-04-21)

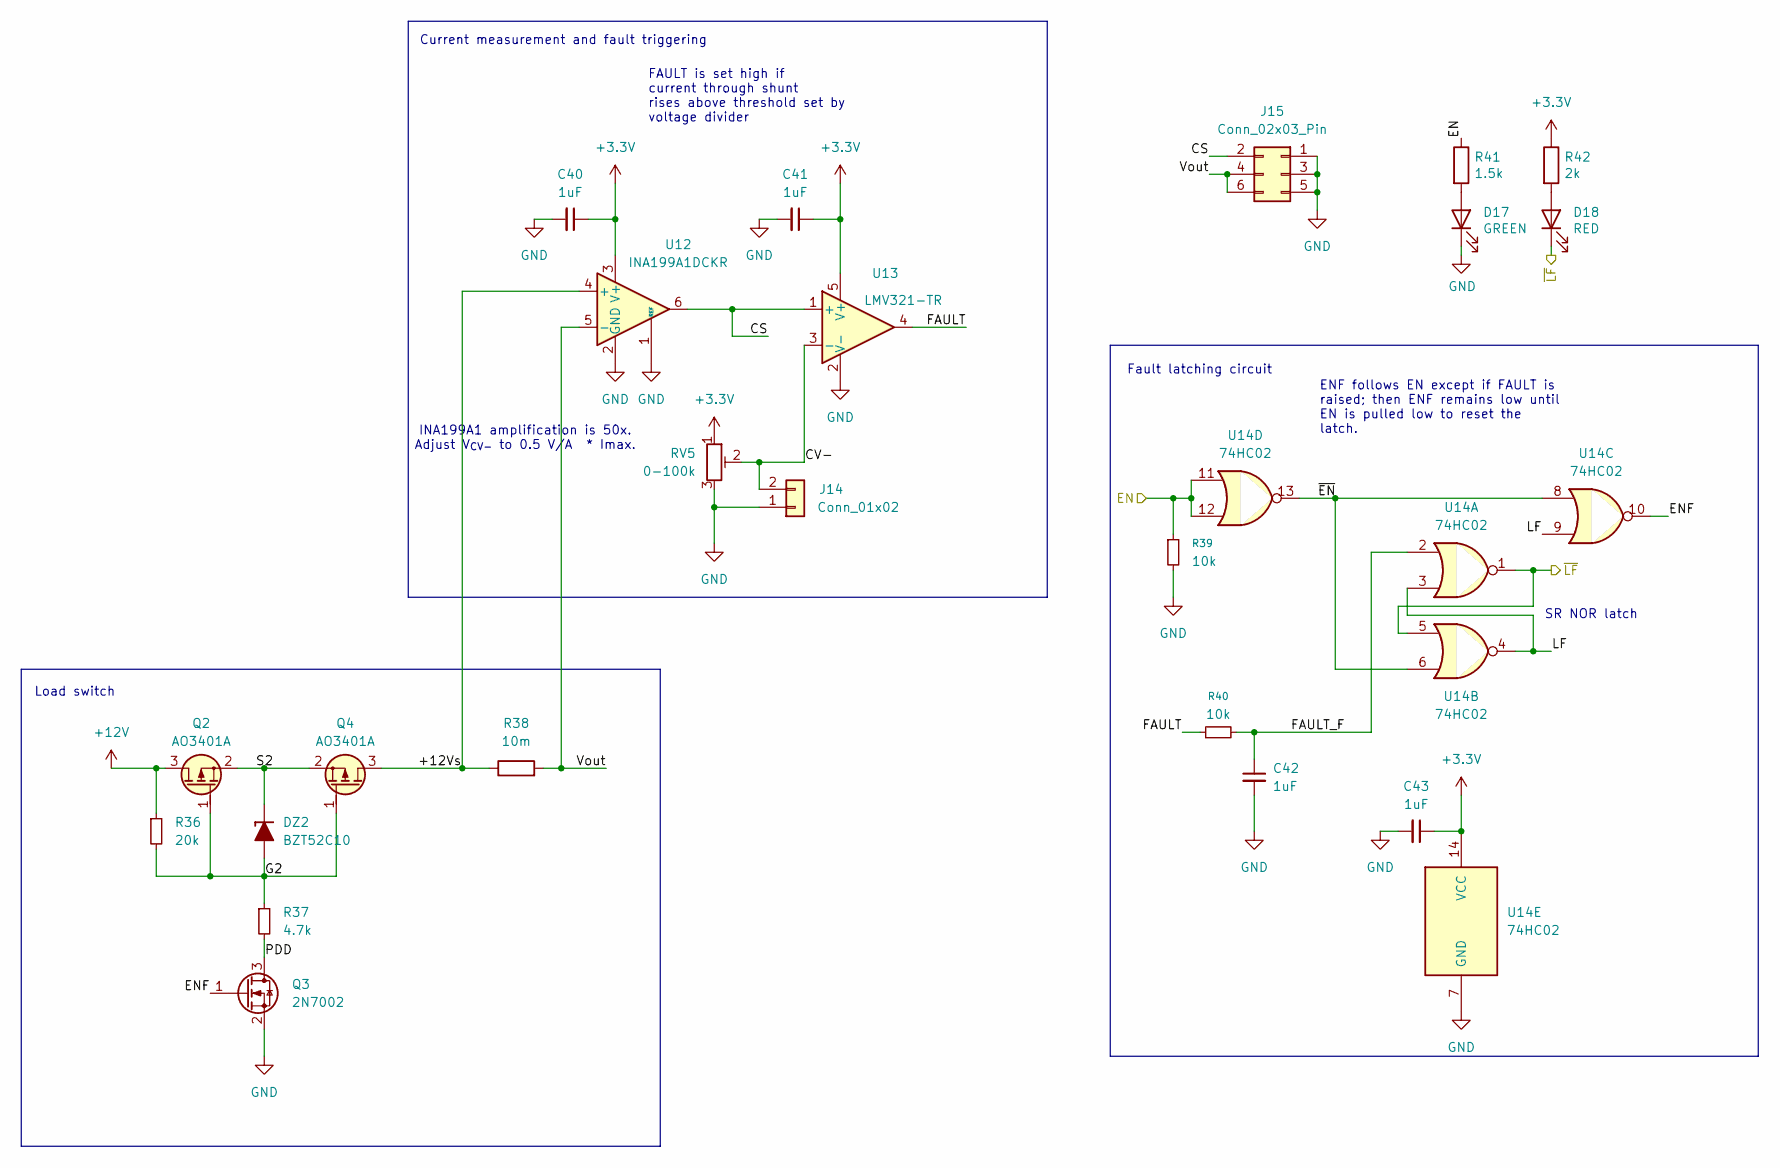
[picture p14: schematic load_switch_12V.kicad_sch]

Parts:
C40, C41, C42, C43: 1uF; C_0603_1608Metric_Pad1.08x0.95mm_HandSolder; LCSC C15849
D17: GREEN; LED_0603_1608Metric; LCSC C84267
D18: RED; LED_0603_1608Metric; LCSC C2286
DZ2: BZT52C10; D_SOD-123; LCSC C173431
J14: Conn_01x02; Pad_1x02_P2.00_1.35x1.35_Rect-Oct
J15: Conn_02x03_Pin; Pad_2x03_P2.54_1.7x1.7_Rect-1Oct-2Rnd; LCSC C2685197
Q2, Q4: AO3401A; SOT-23_Handsoldering; LCSC C15127
Q3: 2N7002; SOT-23; LCSC C8545
R36: 20k; R_0603_1608Metric_Pad0.98x0.95mm_HandSolder; LCSC C4184
R37: 4.7k; R_0603_1608Metric_Pad0.98x0.95mm_HandSolder; LCSC C23162
R38: 10m; R_1206_3216Metric_Pad1.30x1.75mm_HandSolder; LCSC C105362
R39, R40: 10k; R_0603_1608Metric_Pad0.98x0.95mm_HandSolder; LCSC C25804
R41: 1.5k; R_0603_1608Metric; LCSC C22843
R42: 2k; R_0603_1608Metric; LCSC C22975
RV5: 0-100k; RES-ADJ-TH_3P-L9.5-W4.9-P2.50-L_3296W; LCSC C118963
U12: INA199A1DCKR; SOT-363_SC-70-6; LCSC C59135
U13: LMV321-TR; SOT-23-5; LCSC C362273
U14: 74HC02; SOIC-14_3.9x8.7mm_P1.27mm; LCSC C5145448

Connections:
+3.3V: C40.1, C41.1, C43.1, R42.1, RV5.1, U12.3 (V+), U13.5 (V+), U14.14 (VCC)
+12V: Q2.3 (D), R36.1
+12Vs: Q4.3 (D), R38.1, U12.4 (+)
CS: J15.2, U12.6, U13.1 (+)
CV-: J14.2, RV5.2, U13.3 (-)
EN: R39.1, R41.1, U14.11, U14.12
ENF: Q3.1 (G), U14.10
FAULT: R40.1, U13.4
FAULT_F: C42.1, R40.2, U14.2
G2: DZ2.2 (A), Q2.1 (G), Q4.1 (G), R36.2, R37.1
GND: C40.2, C41.2, C42.2, C43.2, D17.1 (K), J14.1, J15.1, J15.3, J15.5, Q3.2 (S), R39.2, RV5.3, U12.1 (REF), U12.2 (GND), U13.2 (V-), U14.7 (GND)
LF: U14.3, U14.4, U14.9
unnamed: D17.2 (A), R41.2
unnamed: D18.2 (A), R42.2
PDD: Q3.3 (D), R37.2
S2: DZ2.1 (K), Q2.2 (S), Q4.2 (S)
Vout: J15.4, J15.6, R38.2, U12.5 (-)
~EN: U14.6, U14.8, U14.13
~LF: D18.1 (K), U14.1, U14.5

Notes on the sheet:
Load switch
Fault latching circuit
ENF follows EN except if FAULT is raised; then ENF remains low until EN is pulled low to reset the latch.
INA199A1 amplification is 50x. Adjust V_{CV-} to 0.5 V/A * Imax.
FAULT is set high if current through shunt rises above threshold set by voltage divider
SR NOR latch
Current measurement and fault triggering
