hatlabs/HALSPA-hardware/mcu2.kicad_sch

## KiCad design mcu2.kicad_sch (2026-04-21)

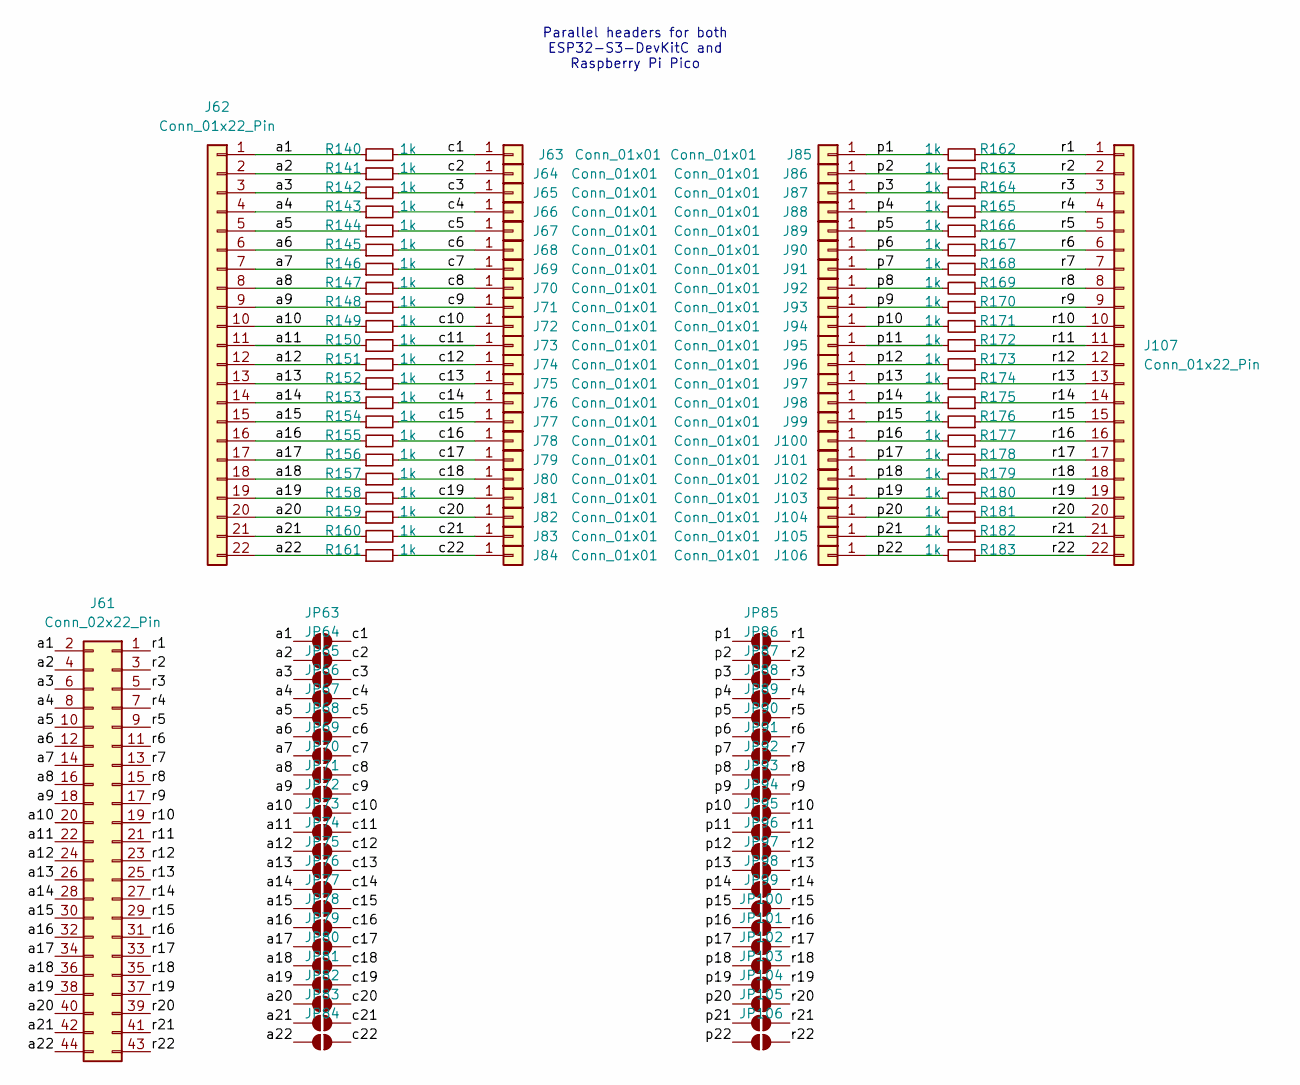
[picture p15: schematic mcu2.kicad_sch]

Parts:
J61: Conn_02x22_Pin; Pad_2x22_P2.54_1.7x1.7_Oct; LCSC C7430418
J62, J107: Conn_01x22_Pin; Pad_1x22_P2.54_1.7x1.7_Oct; LCSC C7430378
J63, J64, J65, J66, J67, J68, J69, J70, J71, J72, J73, J74, J75, J76, J77, J78, J79, J80, J81, J82, J83, J84, J85, J86, J87, J88, J89, J90, J91, J92, J93, J94, J95, J96, J97, J98, J99, J100, J101, J102, J103, J104, J105, J106: Conn_01x01; Pad_1x04_P2.54_1.7x1.7_Oct_Connected
JP63, JP64, JP65, JP66, JP67, JP68, JP69, JP70, JP71, JP72, JP73, JP74, JP75, JP76, JP77, JP78, JP79, JP80, JP81, JP82, JP83, JP84, JP85, JP86, JP87, JP88, JP89, JP90, JP91, JP92, JP93, JP94, JP95, JP96, JP97, JP98, JP99, JP100, JP101, JP102, JP103, JP104, JP105, JP106: SolderJumper_2_Open; SolderJumper-2_P1.3mm_Open_TrianglePad1.0x1.5mm
R140, R141, R142, R143, R144, R145, R146, R147, R148, R149, R150, R151, R152, R153, R154, R155, R156, R157, R158, R159, R160, R161, R162, R163, R164, R165, R166, R167, R168, R169, R170, R171, R172, R173, R174, R175, R176, R177, R178, R179, R180, R181, R182, R183: 1k; R_0402_1005Metric; LCSC C11702

Connections:
a1: J61.2, J62.1, JP63.1 (A), R140.1
a2: J61.4, J62.2, JP64.1 (A), R141.1
a3: J61.6, J62.3, JP65.1 (A), R142.1
a4: J61.8, J62.4, JP66.1 (A), R143.1
a5: J61.10, J62.5, JP67.1 (A), R144.1
a6: J61.12, J62.6, JP68.1 (A), R145.1
a7: J61.14, J62.7, JP69.1 (A), R146.1
a8: J61.16, J62.8, JP70.1 (A), R147.1
a9: J61.18, J62.9, JP71.1 (A), R148.1
a10: J61.20, J62.10, JP72.1 (A), R149.1
a11: J61.22, J62.11, JP73.1 (A), R150.1
a12: J61.24, J62.12, JP74.1 (A), R151.1
a13: J61.26, J62.13, JP75.1 (A), R152.1
a14: J61.28, J62.14, JP76.1 (A), R153.1
a15: J61.30, J62.15, JP77.1 (A), R154.1
a16: J61.32, J62.16, JP78.1 (A), R155.1
a17: J61.34, J62.17, JP79.1 (A), R156.1
a18: J61.36, J62.18, JP80.1 (A), R157.1
a19: J61.38, J62.19, JP81.1 (A), R158.1
a20: J61.40, J62.20, JP82.1 (A), R159.1
a21: J61.42, J62.21, JP83.1 (A), R160.1
a22: J61.44, J62.22, JP84.1 (A), R161.1
c1: J63.1, JP63.2 (B), R140.2
c2: J64.1, JP64.2 (B), R141.2
c3: J65.1, JP65.2 (B), R142.2
c4: J66.1, JP66.2 (B), R143.2
c5: J67.1, JP67.2 (B), R144.2
c6: J68.1, JP68.2 (B), R145.2
c7: J69.1, JP69.2 (B), R146.2
c8: J70.1, JP70.2 (B), R147.2
c9: J71.1, JP71.2 (B), R148.2
c10: J72.1, JP72.2 (B), R149.2
c11: J73.1, JP73.2 (B), R150.2
c12: J74.1, JP74.2 (B), R151.2
c13: J75.1, JP75.2 (B), R152.2
c14: J76.1, JP76.2 (B), R153.2
c15: J77.1, JP77.2 (B), R154.2
c16: J78.1, JP78.2 (B), R155.2
c17: J79.1, JP79.2 (B), R156.2
c18: J80.1, JP80.2 (B), R157.2
c19: J81.1, JP81.2 (B), R158.2
c20: J82.1, JP82.2 (B), R159.2
c21: J83.1, JP83.2 (B), R160.2
c22: J84.1, JP84.2 (B), R161.2
p1: J85.1, JP85.1 (A), R162.2
p2: J86.1, JP86.1 (A), R163.2
p3: J87.1, JP87.1 (A), R164.2
p4: J88.1, JP88.1 (A), R165.2
p5: J89.1, JP89.1 (A), R166.2
p6: J90.1, JP90.1 (A), R167.2
p7: J91.1, JP91.1 (A), R168.2
p8: J92.1, JP92.1 (A), R169.2
p9: J93.1, JP93.1 (A), R170.2
p10: J94.1, JP94.1 (A), R171.2
p11: J95.1, JP95.1 (A), R172.2
p12: J96.1, JP96.1 (A), R173.2
p13: J97.1, JP97.1 (A), R174.2
p14: J98.1, JP98.1 (A), R175.2
p15: J99.1, JP99.1 (A), R176.2
p16: J100.1, JP100.1 (A), R177.2
p17: J101.1, JP101.1 (A), R178.2
p18: J102.1, JP102.1 (A), R179.2
p19: J103.1, JP103.1 (A), R180.2
p20: J104.1, JP104.1 (A), R181.2
p21: J105.1, JP105.1 (A), R182.2
p22: J106.1, JP106.1 (A), R183.2
r1: J61.1, J107.1, JP85.2 (B), R162.1
r2: J61.3, J107.2, JP86.2 (B), R163.1
r3: J61.5, J107.3, JP87.2 (B), R164.1
r4: J61.7, J107.4, JP88.2 (B), R165.1
r5: J61.9, J107.5, JP89.2 (B), R166.1
r6: J61.11, J107.6, JP90.2 (B), R167.1
r7: J61.13, J107.7, JP91.2 (B), R168.1
r8: J61.15, J107.8, JP92.2 (B), R169.1
r9: J61.17, J107.9, JP93.2 (B), R170.1
r10: J61.19, J107.10, JP94.2 (B), R171.1
r11: J61.21, J107.11, JP95.2 (B), R172.1
r12: J61.23, J107.12, JP96.2 (B), R173.1
r13: J61.25, J107.13, JP97.2 (B), R174.1
r14: J61.27, J107.14, JP98.2 (B), R175.1
r15: J61.29, J107.15, JP99.2 (B), R176.1
r16: J61.31, J107.16, JP100.2 (B), R177.1
r17: J61.33, J107.17, JP101.2 (B), R178.1
r18: J61.35, J107.18, JP102.2 (B), R179.1
r19: J61.37, J107.19, JP103.2 (B), R180.1
r20: J61.39, J107.20, JP104.2 (B), R181.1
r21: J61.41, J107.21, JP105.2 (B), R182.1
r22: J61.43, J107.22, JP106.2 (B), R183.1

Notes on the sheet:
Parallel headers for both ESP32-S3-DevKitC and Raspberry Pi Pico
