hatlabs/HALSPA-hardware/mcu.kicad_sch

## KiCad design mcu.kicad_sch (2026-04-21)

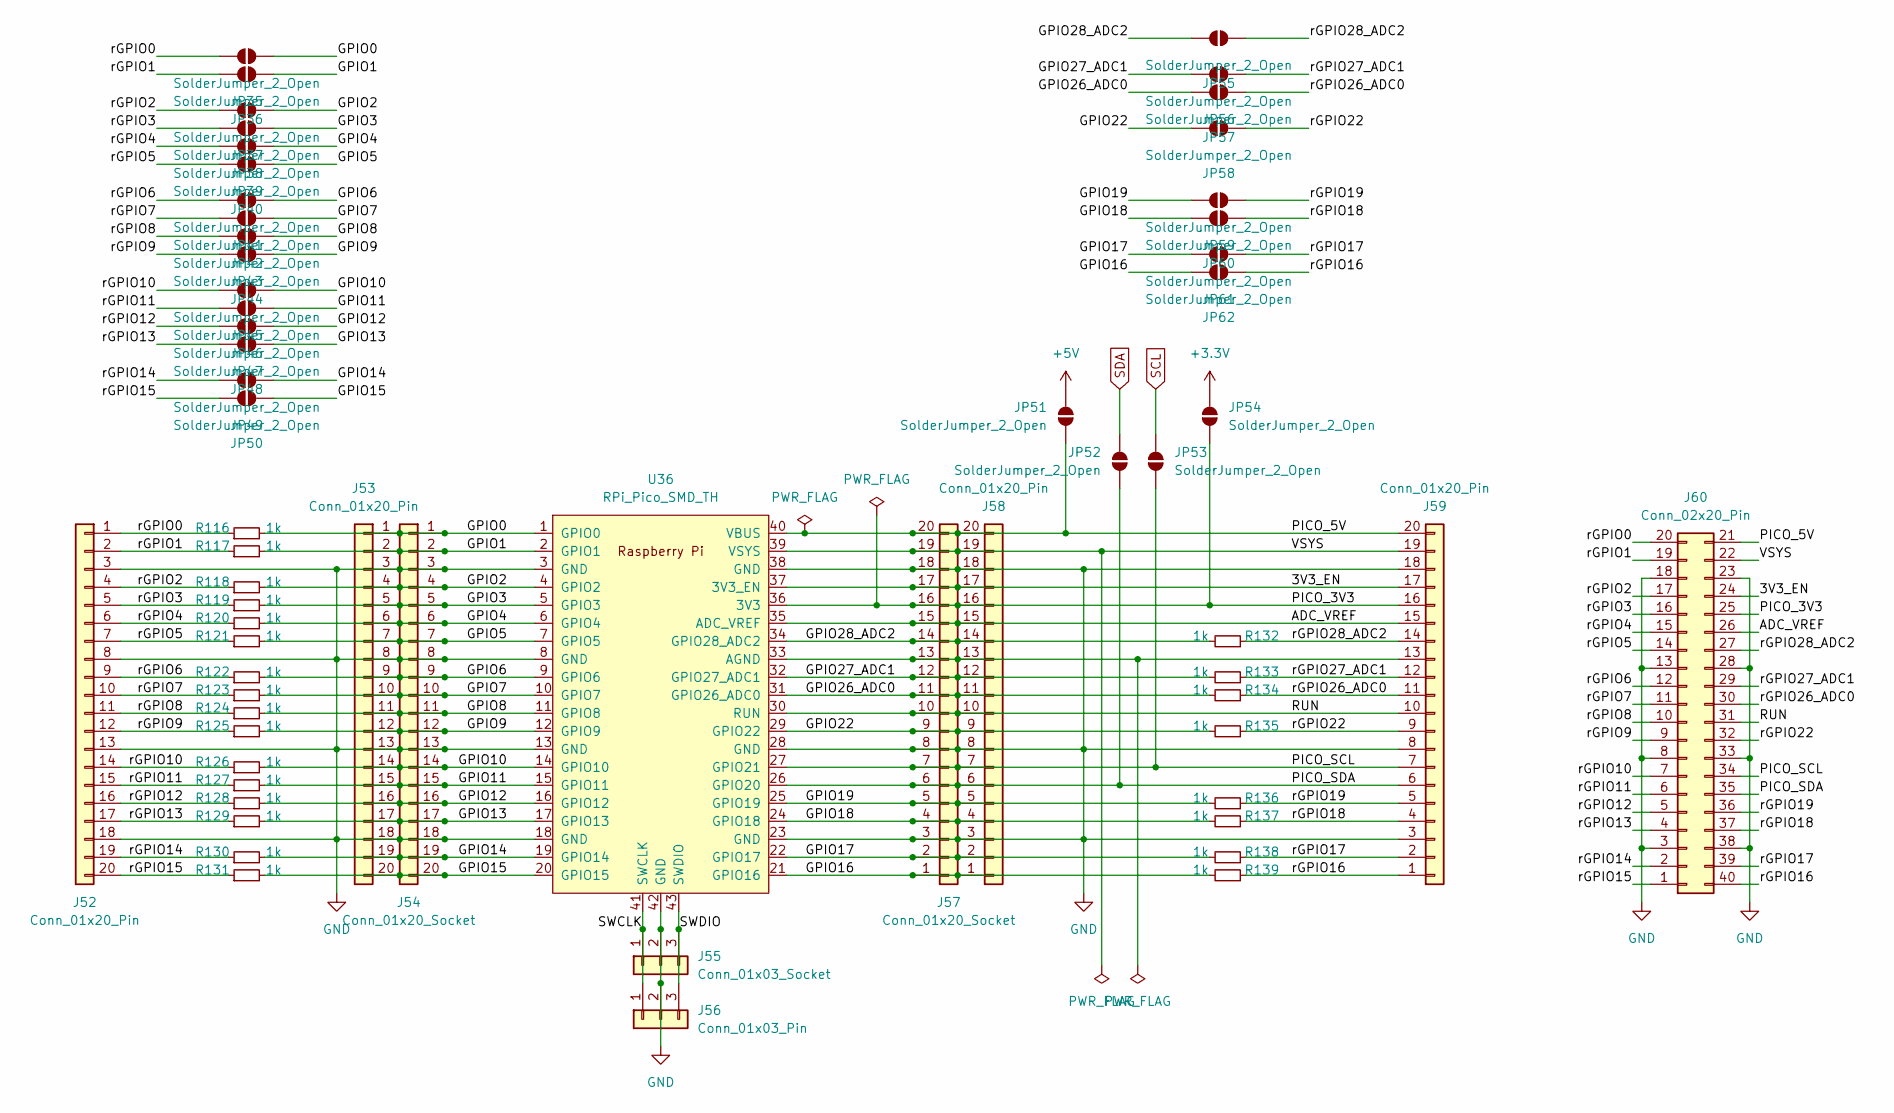
[picture p16: schematic mcu.kicad_sch]

Parts:
J52, J53, J58, J59: Conn_01x20_Pin; Pad_1x20_P2.54_1.7x1.7_Oct; LCSC C50981
J54, J57: Conn_01x20_Socket; Pad_1x20_P2.54_1.7x1.7_Oct; LCSC C25503124
J55: Conn_01x03_Socket; Pad_1x03_P2.54_1.7x1.7_Oct-Rect-Oct; LCSC C7509516
J56: Conn_01x03_Pin; Pad_1x03_P2.54_1.7x1.7_Oct-Rect-Oct; LCSC C49257
J60: Conn_02x20_Pin; Pad_2x20_P2.54_1.7x1.7_Pico; LCSC C5224014
JP35, JP36, JP37, JP38, JP39, JP40, JP41, JP42, JP43, JP44, JP45, JP46, JP47, JP48, JP49, JP50, JP51, JP52, JP53, JP54, JP55, JP56, JP57, JP58, JP59, JP60, JP61, JP62: SolderJumper_2_Open; SolderJumper-2_P1.3mm_Open_TrianglePad1.0x1.5mm
R116, R117, R118, R119, R120, R121, R122, R123, R124, R125, R126, R127, R128, R129, R130, R131, R132, R133, R134, R135, R136, R137, R138, R139: 1k; R_0402_1005Metric; LCSC C11702
U36: RPi_Pico_SMD_TH; RPi_Pico_Outline

Connections:
3V3_EN: J57.17, J58.17, J59.17, J60.24, U36.37 (3V3_EN)
+3.3V: JP54.2 (B)
+5V: JP51.2 (B)
ADC_VREF: J57.15, J58.15, J59.15, J60.26, U36.35 (ADC_VREF)
GND: J52.3, J52.8, J52.13, J52.18, J53.3, J53.8, J53.13, J53.18, J54.3, J54.8, J54.13, J54.18, J55.2, J56.2, J57.3, J57.8, J57.18, J58.3, J58.8, J58.18, J59.3, J59.8, J59.18, J60.3, J60.8, J60.13, J60.18, J60.23, J60.28, J60.33, J60.38, U36.3 (GND), U36.8 (GND), U36.13 (GND), U36.18 (GND), U36.23 (GND), U36.28 (GND), U36.38 (GND), U36.42 (GND)
GPIO0: J53.1, J54.1, JP35.1 (A), R116.2, U36.1 (GPIO0)
GPIO1: J53.2, J54.2, JP36.1 (A), R117.2, U36.2 (GPIO1)
GPIO2: J53.4, J54.4, JP37.1 (A), R118.2, U36.4 (GPIO2)
GPIO3: J53.5, J54.5, JP38.1 (A), R119.2, U36.5 (GPIO3)
GPIO4: J53.6, J54.6, JP39.1 (A), R120.2, U36.6 (GPIO4)
GPIO5: J53.7, J54.7, JP40.1 (A), R121.2, U36.7 (GPIO5)
GPIO6: J53.9, J54.9, JP41.1 (A), R122.2, U36.9 (GPIO6)
GPIO7: J53.10, J54.10, JP42.1 (A), R123.2, U36.10 (GPIO7)
GPIO8: J53.11, J54.11, JP43.1 (A), R124.2, U36.11 (GPIO8)
GPIO9: J53.12, J54.12, JP44.1 (A), R125.2, U36.12 (GPIO9)
GPIO10: J53.14, J54.14, JP45.1 (A), R126.2, U36.14 (GPIO10)
GPIO11: J53.15, J54.15, JP46.1 (A), R127.2, U36.15 (GPIO11)
GPIO12: J53.16, J54.16, JP47.1 (A), R128.2, U36.16 (GPIO12)
GPIO13: J53.17, J54.17, JP48.1 (A), R129.2, U36.17 (GPIO13)
GPIO14: J53.19, J54.19, JP49.1 (A), R130.2, U36.19 (GPIO14)
GPIO15: J53.20, J54.20, JP50.1 (A), R131.2, U36.20 (GPIO15)
GPIO16: J57.1, J58.1, JP62.2 (B), R139.2, U36.21 (GPIO16)
GPIO17: J57.2, J58.2, JP61.2 (B), R138.2, U36.22 (GPIO17)
GPIO18: J57.4, J58.4, JP60.2 (B), R137.2, U36.24 (GPIO18)
GPIO19: J57.5, J58.5, JP59.2 (B), R136.2, U36.25 (GPIO19)
GPIO22: J57.9, J58.9, JP58.2 (B), R135.2, U36.29 (GPIO22)
GPIO26_ADC0: J57.11, J58.11, JP57.2 (B), R134.2, U36.31 (GPIO26_ADC0)
GPIO27_ADC1: J57.12, J58.12, JP56.2 (B), R133.2, U36.32 (GPIO27_ADC1)
GPIO28_ADC2: J57.14, J58.14, JP55.2 (B), R132.2, U36.34 (GPIO28_ADC2)
unnamed: J57.13, J58.13, J59.13, U36.33 (AGND)
PICO_3V3: J57.16, J58.16, J59.16, J60.25, JP54.1 (A), U36.36 (3V3)
PICO_5V: J57.20, J58.20, J59.20, J60.21, JP51.1 (A), U36.40 (VBUS)
PICO_SCL: J57.7, J58.7, J59.7, J60.34, JP53.1 (A), U36.27 (GPIO21)
PICO_SDA: J57.6, J58.6, J59.6, J60.35, JP52.1 (A), U36.26 (GPIO20)
RUN: J57.10, J58.10, J59.10, J60.31, U36.30 (RUN)
SCL: JP53.2 (B)
SDA: JP52.2 (B)
SWCLK: J55.1, J56.1, U36.41 (SWCLK)
SWDIO: J55.3, J56.3, U36.43 (SWDIO)
VSYS: J57.19, J58.19, J59.19, J60.22, U36.39 (VSYS)
rGPIO0: J52.1, J60.20, JP35.2 (B), R116.1
rGPIO1: J52.2, J60.19, JP36.2 (B), R117.1
rGPIO2: J52.4, J60.17, JP37.2 (B), R118.1
rGPIO3: J52.5, J60.16, JP38.2 (B), R119.1
rGPIO4: J52.6, J60.15, JP39.2 (B), R120.1
rGPIO5: J52.7, J60.14, JP40.2 (B), R121.1
rGPIO6: J52.9, J60.12, JP41.2 (B), R122.1
rGPIO7: J52.10, J60.11, JP42.2 (B), R123.1
rGPIO8: J52.11, J60.10, JP43.2 (B), R124.1
rGPIO9: J52.12, J60.9, JP44.2 (B), R125.1
rGPIO10: J52.14, J60.7, JP45.2 (B), R126.1
rGPIO11: J52.15, J60.6, JP46.2 (B), R127.1
rGPIO12: J52.16, J60.5, JP47.2 (B), R128.1
rGPIO13: J52.17, J60.4, JP48.2 (B), R129.1
rGPIO14: J52.19, J60.2, JP49.2 (B), R130.1
rGPIO15: J52.20, J60.1, JP50.2 (B), R131.1
rGPIO16: J59.1, J60.40, JP62.1 (A), R139.1
rGPIO17: J59.2, J60.39, JP61.1 (A), R138.1
rGPIO18: J59.4, J60.37, JP60.1 (A), R137.1
rGPIO19: J59.5, J60.36, JP59.1 (A), R136.1
rGPIO22: J59.9, J60.32, JP58.1 (A), R135.1
rGPIO26_ADC0: J59.11, J60.30, JP57.1 (A), R134.1
rGPIO27_ADC1: J59.12, J60.29, JP56.1 (A), R133.1
rGPIO28_ADC2: J59.14, J60.27, JP55.1 (A), R132.1
