hatlabs/HALSPA-hardware/opamp.kicad_sch

## KiCad design opamp.kicad_sch (2026-04-21)

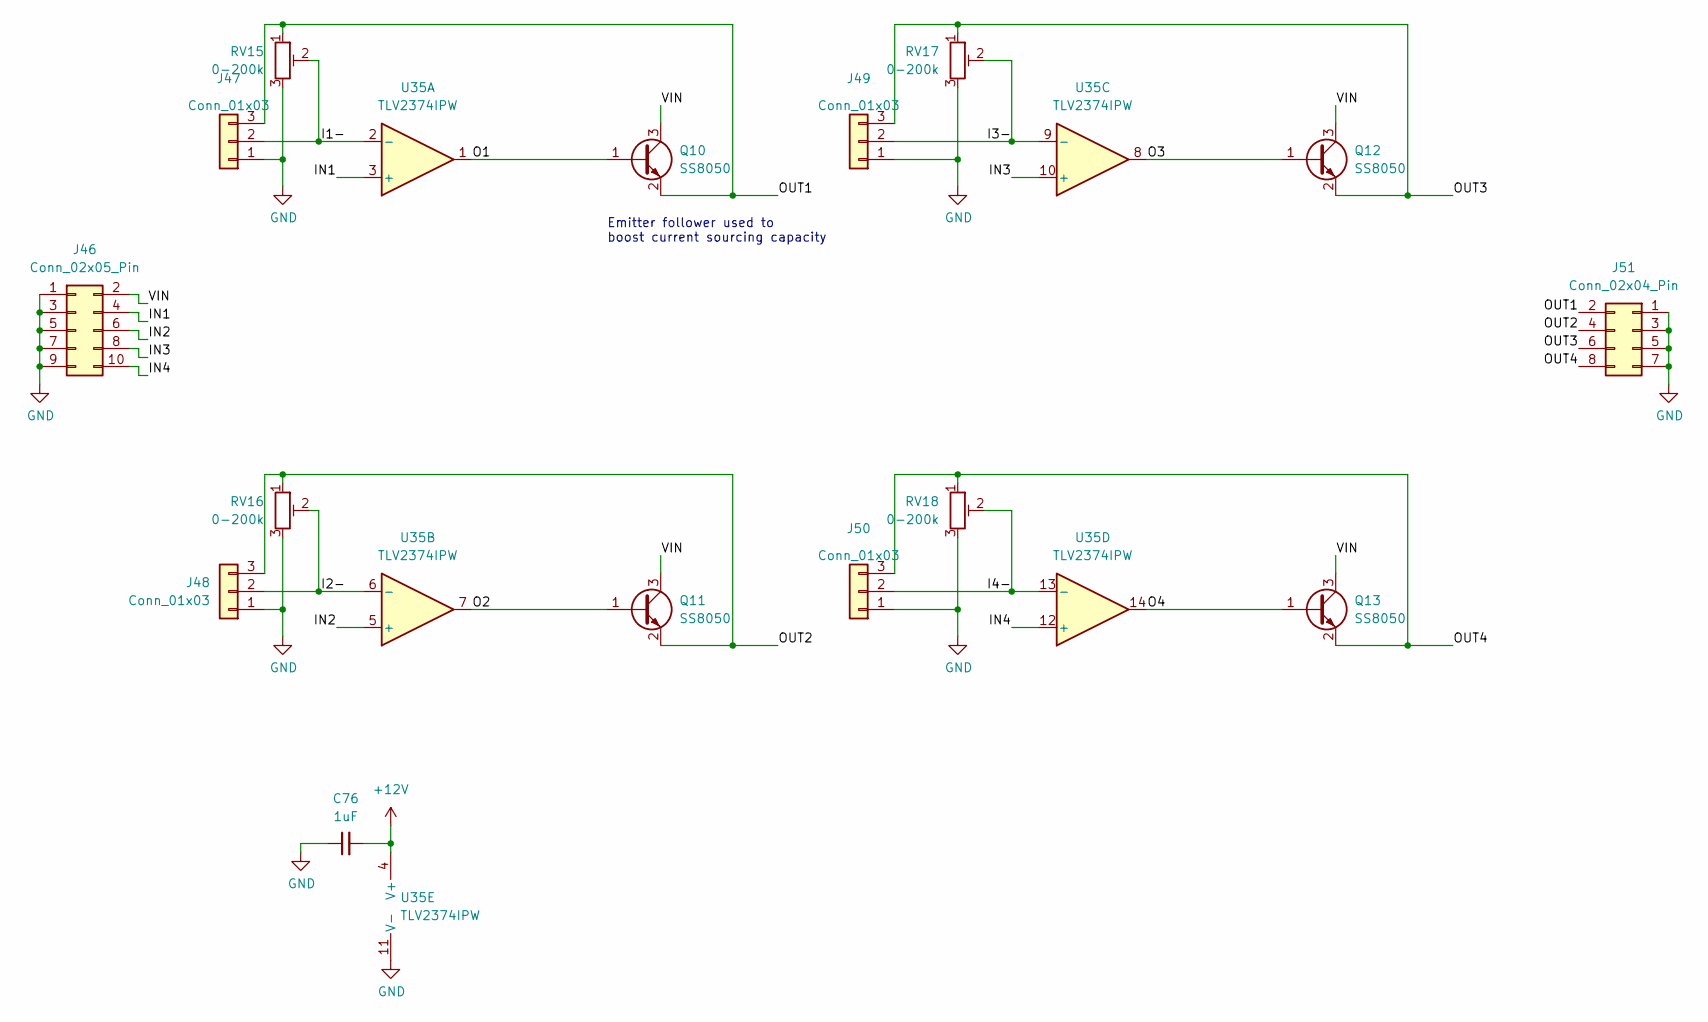
[picture p17: schematic opamp.kicad_sch]

Parts:
C76: 1uF; C_0603_1608Metric_Pad1.08x0.95mm_HandSolder; LCSC C15849
J46: Conn_02x05_Pin; Pad_2x05_P2.54_1.7x1.7_Rect-1Rnd-4Oct; LCSC C5383106
J47, J48, J49, J50: Conn_01x03; Pad_1x03_P2.00_1.35x1.35_Rect-2Oct
J51: Conn_02x04_Pin; Pad_2x04_P2.54_1.7x1.7_Rect-Oct; LCSC C5383105
Q10, Q11, Q12, Q13: SS8050; SOT-23_Handsoldering; LCSC C2150
RV15, RV16, RV17, RV18: 0-200k; RES-ADJ-TH_3P-L9.5-W4.9-P2.50-L_3296W; LCSC C118942
U35: TLV2374IPW; TSSOP-14_4.4x5mm_P0.65mm; LCSC C468244

Connections:
+12V: C76.2, U35.4 (V+)
GND: C76.1, J46.1, J46.3, J46.5, J46.7, J46.9, J47.1, J48.1, J49.1, J50.1, J51.1, J51.3, J51.5, J51.7, RV15.3, RV16.3, RV17.3, RV18.3, U35.11 (V-)
I1-: J47.2, RV15.2, U35.2 (-)
I2-: J48.2, RV16.2, U35.6 (-)
I3-: J49.2, RV17.2, U35.9 (-)
I4-: J50.2, RV18.2, U35.13 (-)
IN1: J46.4, U35.3 (+)
IN2: J46.6, U35.5 (+)
IN3: J46.8, U35.10 (+)
IN4: J46.10, U35.12 (+)
O1: Q10.1 (B), U35.1
O2: Q11.1 (B), U35.7
O3: Q12.1 (B), U35.8
O4: Q13.1 (B), U35.14
OUT1: J47.3, J51.2, Q10.2 (E), RV15.1
OUT2: J48.3, J51.4, Q11.2 (E), RV16.1
OUT3: J49.3, J51.6, Q12.2 (E), RV17.1
OUT4: J50.3, J51.8, Q13.2 (E), RV18.1
VIN: J46.2, Q10.3 (C), Q11.3 (C), Q12.3 (C), Q13.3 (C)

Notes on the sheet:
Emitter follower used to boost current sourcing capacity
