hatlabs/HALSPA-hardware/pcb.kicad_sch

## KiCad design pcb.kicad_sch (2026-04-21)

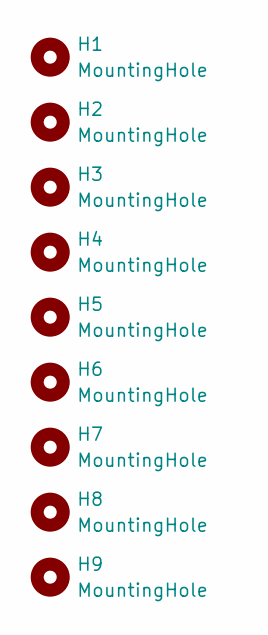
[picture p18: schematic pcb.kicad_sch]

Parts:
H1, H2, H3, H4, H5, H6, H7, H8, H9: MountingHole; MountingHole_3.2mm_M3_NoFill
