hatlabs/HALSPA-hardware/power_conx.kicad_sch

## KiCad design power_conx.kicad_sch (2026-04-21)

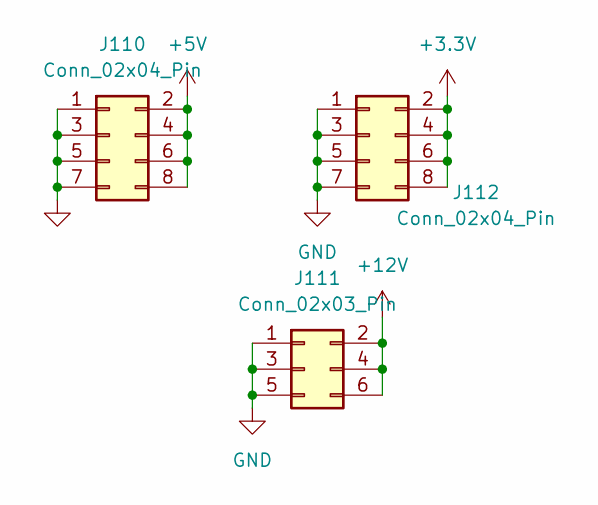
[picture p19: schematic power_conx.kicad_sch]

Parts:
J110, J112: Conn_02x04_Pin; Pad_2x04_P2.54_1.7x1.7_Rect-Rnd; LCSC C7501275
J111: Conn_02x03_Pin; Pad_2x03_P2.54_1.7x1.7_Rect-Rnd; JLCPCB_CORRECTION 1.27;-2.54;270

Connections:
+3.3V: J112.2, J112.4, J112.6, J112.8
+5V: J110.2, J110.4, J110.6, J110.8
+12V: J111.2, J111.4, J111.6
GND: J110.1, J110.3, J110.5, J110.7, J111.1, J111.3, J111.5, J112.1, J112.3, J112.5, J112.7
