hatlabs/HALSPA-hardware/powmon.kicad_sch

## KiCad design powmon.kicad_sch (2025-03-21)

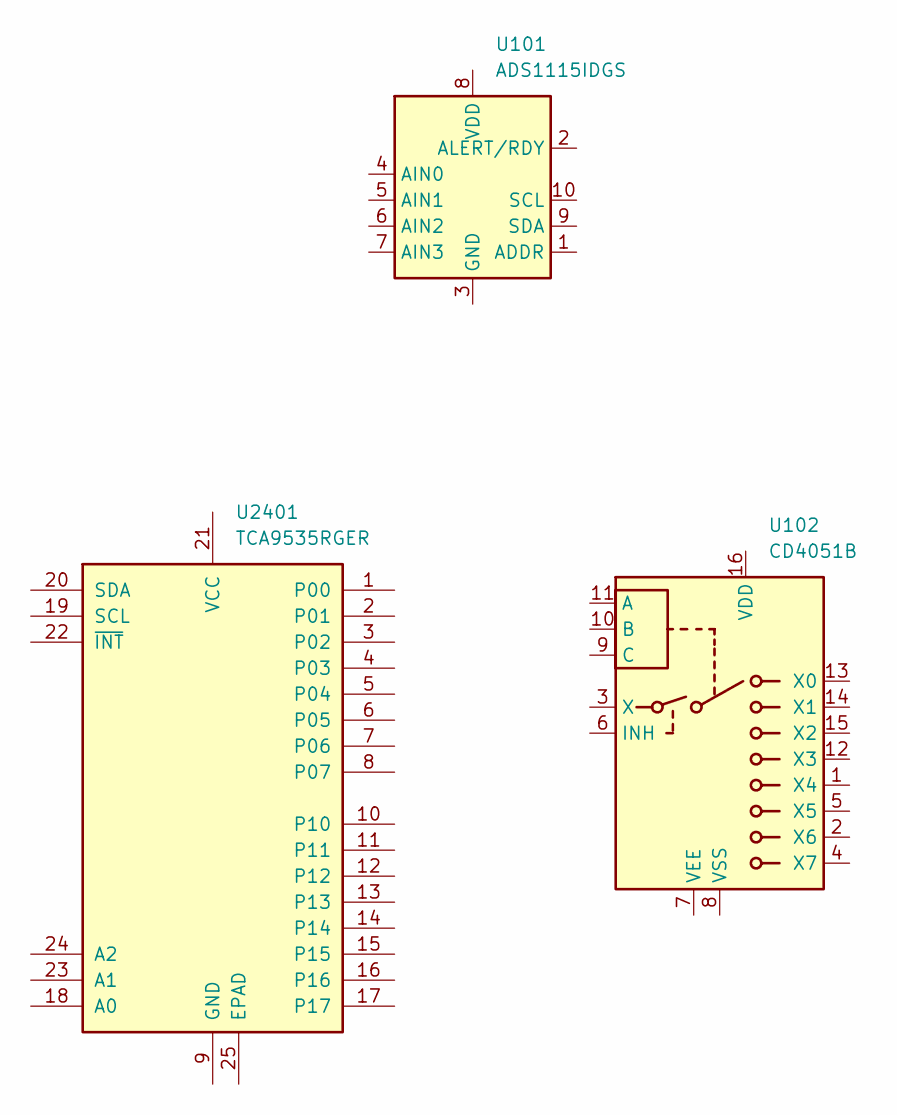
[picture p20: schematic powmon.kicad_sch]

Parts:
U101: ADS1115IDGS; TSSOP-10_3x3mm_P0.5mm
U102: CD4051B
U2401: TCA9535RGER; VQFN-24-1EP_4x4mm_P0.5mm_EP2.45x2.45mm; LCSC C3188776
