hatlabs/HALSPA-hardware/raspi-gpio.kicad_sch

## KiCad design raspi-gpio.kicad_sch (2026-04-21)

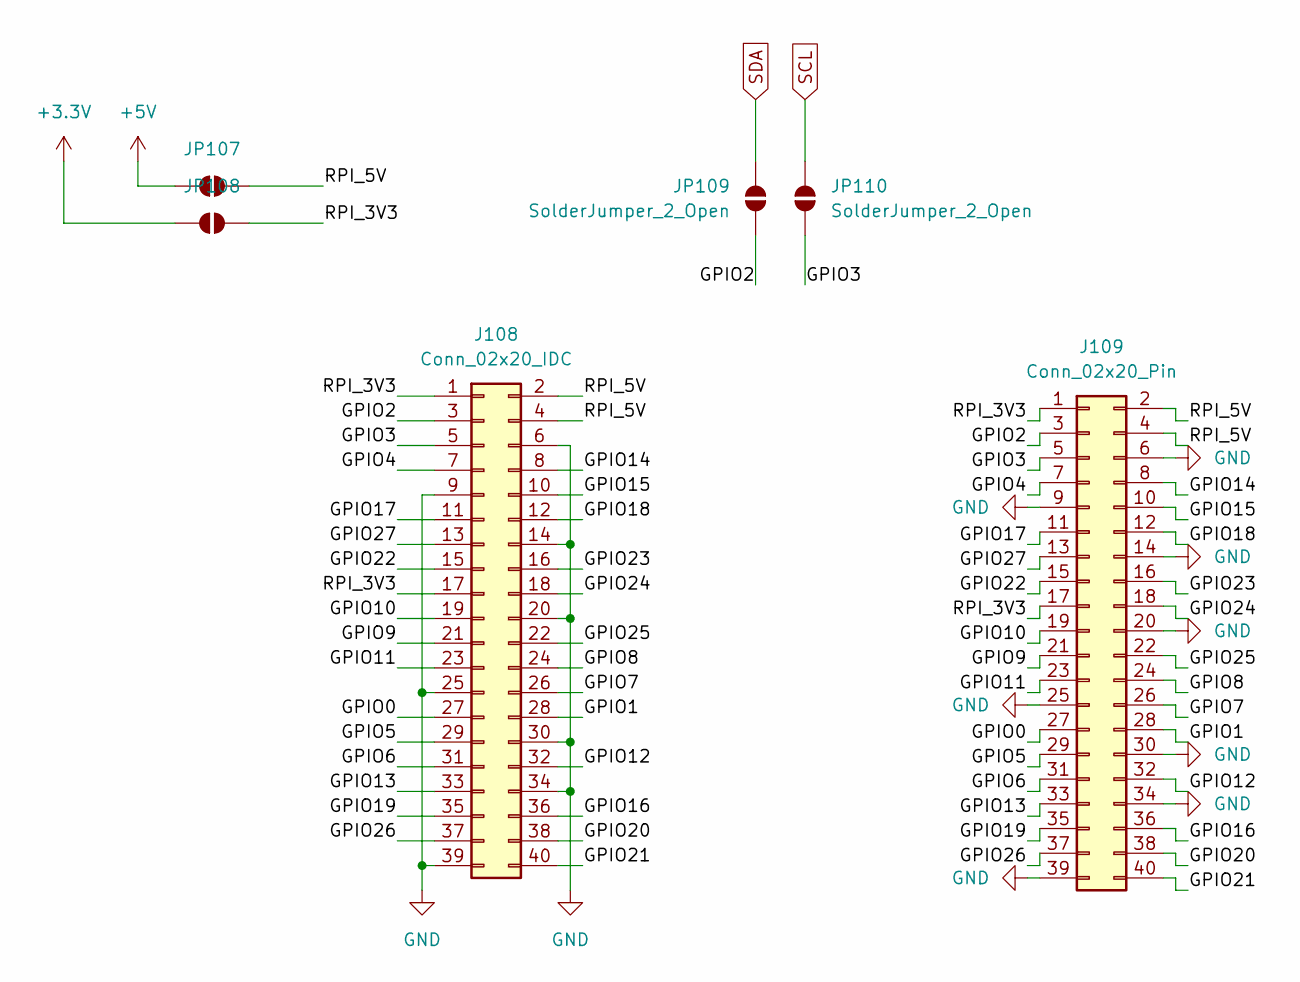
[picture p21: schematic raspi-gpio.kicad_sch]

Parts:
J108: Conn_02x20_IDC; IDC-Header_2x20_P2.54mm_Vertical; LCSC C9138
J109: Conn_02x20_Pin; Pad_2x20_P2.54_1.7x1.7_RPi-GPIO; LCSC C5224014
JP107, JP108, JP109, JP110: SolderJumper_2_Open; SolderJumper-2_P1.3mm_Open_TrianglePad1.0x1.5mm

Connections:
+3.3V: JP108.1 (A)
+5V: JP107.1 (A)
GND: J108.6, J108.9, J108.14, J108.20, J108.25, J108.30, J108.34, J108.39, J109.6, J109.9, J109.14, J109.20, J109.25, J109.30, J109.34, J109.39
GPIO0: J108.27, J109.27
GPIO1: J108.28, J109.28
GPIO2: J108.3, J109.3, JP109.1 (A)
GPIO3: J108.5, J109.5, JP110.1 (A)
GPIO4: J108.7, J109.7
GPIO5: J108.29, J109.29
GPIO6: J108.31, J109.31
GPIO7: J108.26, J109.26
GPIO8: J108.24, J109.24
GPIO9: J108.21, J109.21
GPIO10: J108.19, J109.19
GPIO11: J108.23, J109.23
GPIO12: J108.32, J109.32
GPIO13: J108.33, J109.33
GPIO14: J108.8, J109.8
GPIO15: J108.10, J109.10
GPIO16: J108.36, J109.36
GPIO17: J108.11, J109.11
GPIO18: J108.12, J109.12
GPIO19: J108.35, J109.35
GPIO20: J108.38, J109.38
GPIO21: J108.40, J109.40
GPIO22: J108.15, J109.15
GPIO23: J108.16, J109.16
GPIO24: J108.18, J109.18
GPIO25: J108.22, J109.22
GPIO26: J108.37, J109.37
GPIO27: J108.13, J109.13
RPI_3V3: J108.1, J108.17, J109.1, J109.17, JP108.2 (B)
RPI_5V: J108.2, J108.4, J109.2, J109.4, JP107.2 (B)
SCL: JP110.2 (B)
SDA: JP109.2 (B)
