hatlabs/HALSPA-hardware/usb_conx.kicad_sch

## KiCad design usb_conx.kicad_sch (2026-04-21)

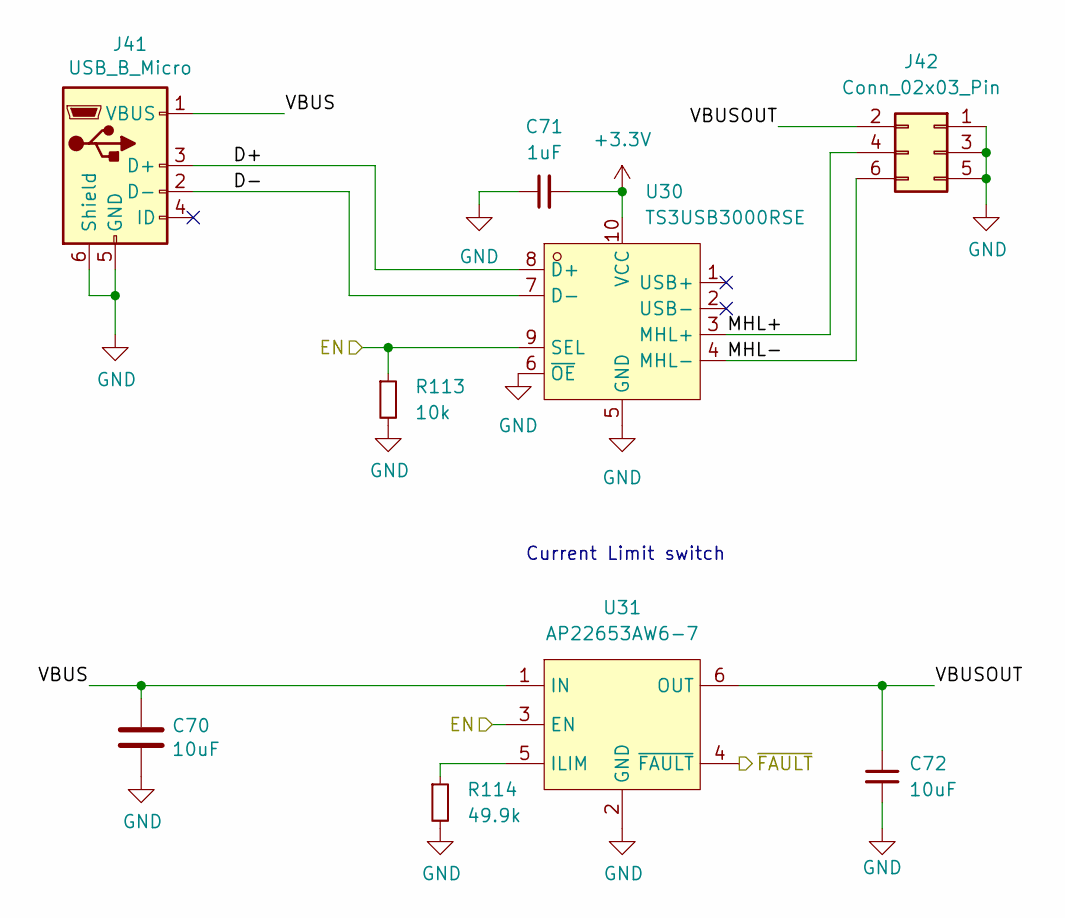
[picture p22: schematic usb_conx.kicad_sch]

Parts:
C70, C72: 10uF; C_0805_2012Metric; LCSC C15850
C71: 1uF; C_0603_1608Metric_Pad1.08x0.95mm_HandSolder; LCSC C15849
J41: USB_B_Micro; MICRO-USB-SMD_920-154A2021Y10109; LCSC C399946
J42: Conn_02x03_Pin; Pad_2x03_P2.54_1.7x1.7_Rect-1Rnd-2Oct_Mirror; LCSC C2685197
R113: 10k; R_0603_1608Metric_Pad0.98x0.95mm_HandSolder; LCSC C25804
R114: 49.9k; R_0603_1608Metric_Pad0.98x0.95mm_HandSolder; LCSC C23184
U30: TS3USB3000RSE; UQFN-10_L2.0-W1.5-P0.50-BL; LCSC C882807
U31: AP22653AW6-7; SOT-23-6; LCSC C1511768

Connections:
+3.3V: C71.2, U30.10 (VCC)
D+: J41.3 (D+), U30.8 (D+)
D-: J41.2 (D-), U30.7 (D-)
EN: R113.1, U30.9 (SEL), U31.3 (EN)
GND: C70.2, C71.1, C72.2, J41.5 (GND), J41.6 (Shield), J42.1, J42.3, J42.5, R113.2, R114.2, U30.5 (GND), U30.6 (~OE), U31.2 (GND)
MHL+: J42.4, U30.3 (MHL+)
MHL-: J42.6, U30.4 (MHL-)
unnamed: R114.1, U31.5 (ILIM)
VBUS: C70.1, J41.1 (VBUS), U31.1 (IN)
VBUSOUT: C72.1, J42.2, U31.6 (OUT)
~FAULT: U31.4 (~FAULT)

Notes on the sheet:
Current Limit switch
