hatlabs/HALSPA-hardware/usb_serial.kicad_sch

## KiCad design usb_serial.kicad_sch (2026-04-21)

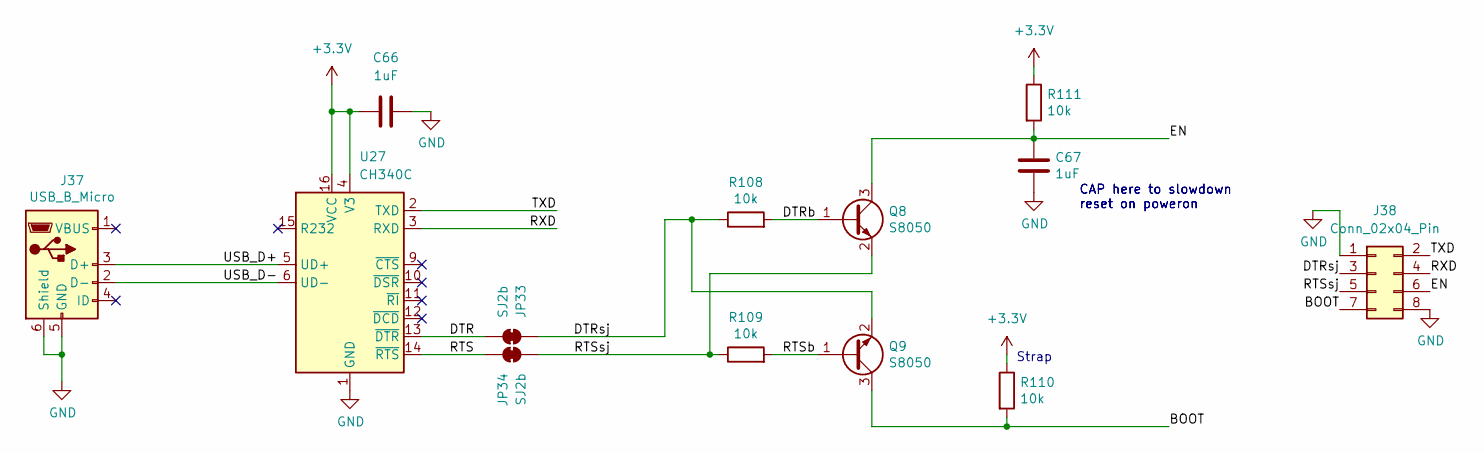
[picture p23: schematic usb_serial.kicad_sch]

Parts:
C66, C67: 1uF; C_0603_1608Metric_Pad1.08x0.95mm_HandSolder; LCSC C15849
J37: USB_B_Micro; MICRO-USB-SMD_920-154A2021Y10109; LCSC C399946
J38: Conn_02x04_Pin; Pad_2x04_P2.54_1.7x1.7_Rect-Oct-Rect; LCSC C7501275
JP33, JP34: SJ2b; SolderJumper-2_P1.3mm_Bridged_Pad1.0x1.5mm
Q8, Q9: S8050; SOT-23_Handsoldering; LCSC C2146
R108, R109, R110, R111: 10k; R_0603_1608Metric_Pad0.98x0.95mm_HandSolder; LCSC C25804
U27: CH340C; SOIC-16_3.9x9.9mm_P1.27mm; LCSC C84681

Connections:
+3.3V: C66.1, R110.1, R111.1, U27.4 (V3), U27.16 (VCC)
BOOT: J38.7, Q9.3 (C), R110.2
DTR: JP33.1 (A), U27.13 (~DTR)
DTRb: Q8.1 (B), R108.2
DTRsj: J38.3, JP33.2 (B), Q9.2 (E), R108.1
EN: C67.1, J38.6, Q8.3 (C), R111.2
GND: C66.2, C67.2, J37.5 (GND), J37.6 (Shield), J38.1, J38.8, U27.1 (GND)
RTS: JP34.2 (B), U27.14 (~RTS)
RTSb: Q9.1 (B), R109.2
RTSsj: J38.5, JP34.1 (A), Q8.2 (E), R109.1
RXD: J38.4, U27.3 (RXD)
TXD: J38.2, U27.2 (TXD)
USB_D+: J37.3 (D+), U27.5 (UD+)
USB_D-: J37.2 (D-), U27.6 (UD-)

Notes on the sheet:
CAP here to slowdown reset on poweron
Strap
