hatlabs/HALSPA-hardware/(commit log)

2025-03-08 Proto version 0.1.0
    [HALTEST.kicad_sch, adc.kicad_sch, ads1115.kicad_sch, anaio.kicad_sch, anamux.kicad_sch, buck_3.3V.kicad_sch, buck_5V.kicad_sch, curlim_12V.kicad_sch]
2025-03-20 Silk screen fixes, snap bottom row voltage rail headers to grid
    [anaio.kicad_sch, dut_power.kicad_sch, raspi-gpio.kicad_sch, usb_serial.kicad_sch]
2025-04-17 WIP v0.2.0 changes
    [HALSPA.kicad_sch, adc.kicad_sch, ads1115.kicad_sch, anaio.kicad_sch, anamux.kicad_sch, buck_3.3V.kicad_sch, buck_5V.kicad_sch, curlim_12V.kicad_sch]
2025-04-17 Assign part numbers and finish other 0.2.0 changes
    [HALSPA.kicad_sch, adc.kicad_sch, ads1115.kicad_sch, anaio.kicad_sch, anamux.kicad_sch, buck_3.3V.kicad_sch, buck_5V.kicad_sch, curlim_12V.kicad_sch]
2025-04-17 Update the title blocks
    [HALSPA.kicad_sch, adc.kicad_sch, ads1115.kicad_sch, anaio.kicad_sch, anamux.kicad_sch, buck_3.3V.kicad_sch, buck_5V.kicad_sch, curlim_12V.kicad_sch]
2025-04-30 Fix minor production issues
    [ads1115.kicad_sch, anaio.kicad_sch, anamux.kicad_sch]
2025-05-14 Add JLCPCB corrections
    [HALSPA.kicad_sch, buck_5V.kicad_sch, curlim_12V.kicad_sch, curlim_2.7-5.5V.kicad_sch, digio.kicad_sch, dut_power.kicad_sch, ina199.kicad_sch, level_shifting.kicad_sch]
2025-05-15 Improve schematics labeling
    [HALSPA.kicad_sch, anaio.kicad_sch, digio.kicad_sch, dut_power.kicad_sch, usb_conx.kicad_sch, usb_serial.kicad_sch]
2025-06-27 Improve MCU2 layout; document curlim12v CSA
    [HALSPA.kicad_sch, anaio.kicad_sch, anamux.kicad_sch, curlim_12V.kicad_sch, digio.kicad_sch, dut_power.kicad_sch, ina199.kicad_sch, mcu.kicad_sch]
2025-06-28 Remove the Kicad prl file from the repo
2025-08-15 Update anamux labeling and title blocks
    [HALSPA.kicad_sch, adc.kicad_sch, ads1115.kicad_sch, anaio.kicad_sch, anamux.kicad_sch, buck_3.3V.kicad_sch, buck_5V.kicad_sch, curlim_12V.kicad_sch]
2025-08-15 Replace micro-usb connectors with horizontal ones
    [usb_conx.kicad_sch, usb_serial.kicad_sch]
2025-08-18 Adjust trimmer test pads
    [ads1115.kicad_sch, anamux.kicad_sch, opamp.kicad_sch]
2025-08-18 Move Pico debug port silkscreen labels
2025-10-09 Assorted fixes
    [HALSPA.kicad_sch, digio.kicad_sch, mcu.kicad_sch, mcu2.kicad_sch, usb_conx.kicad_sch]
2025-10-12 Rename current limiters to load switches
    [load_switch_12V.kicad_sch, load_switch_5v.kicad_sch]
2025-10-12 Use double row connectors for ADC inputs
    [ads1115.kicad_sch]
2025-10-12 FIXUP load switch
    [dut_power.kicad_sch]
2025-10-18 Update the design to a stackable one
    [HALSPA.kicad_sch, adc.kicad_sch, ads1115.kicad_sch, anaio.kicad_sch, anamux.kicad_sch, buck_3.3V.kicad_sch, buck_5V.kicad_sch, current_sense.kicad_sch]
2025-12-20 Edge connector changes
    Probably a number of other unassorted changes as well.
    [HALSPA.kicad_sch, edge_conx.kicad_sch]
2025-12-20 Fix some part numbers
    [anamux.kicad_sch]
2025-12-28 Update 2N7002 symbol from library
    [load_switch_12V.kicad_sch]
2026-04-21 chore: fix license header — correct project name and repo URL
