hatlabs/HALSPA-hardware/(notices)

Notices in the files:
anamux.kicad_sch:
HALSPA is licensed under CERN-OHL-S v2.
